barisdinc/ASELSAN_4822/Arduino_Nano_TAMSAT_KIT/Hardware/README.md

Bu dizinde sema, PCB  calismalari vb. yer alacak
