barisdinc/ASELSAN_4822/ESP32_TA1GI/docs/K3 1.resim.pdf

t;

## !ııl

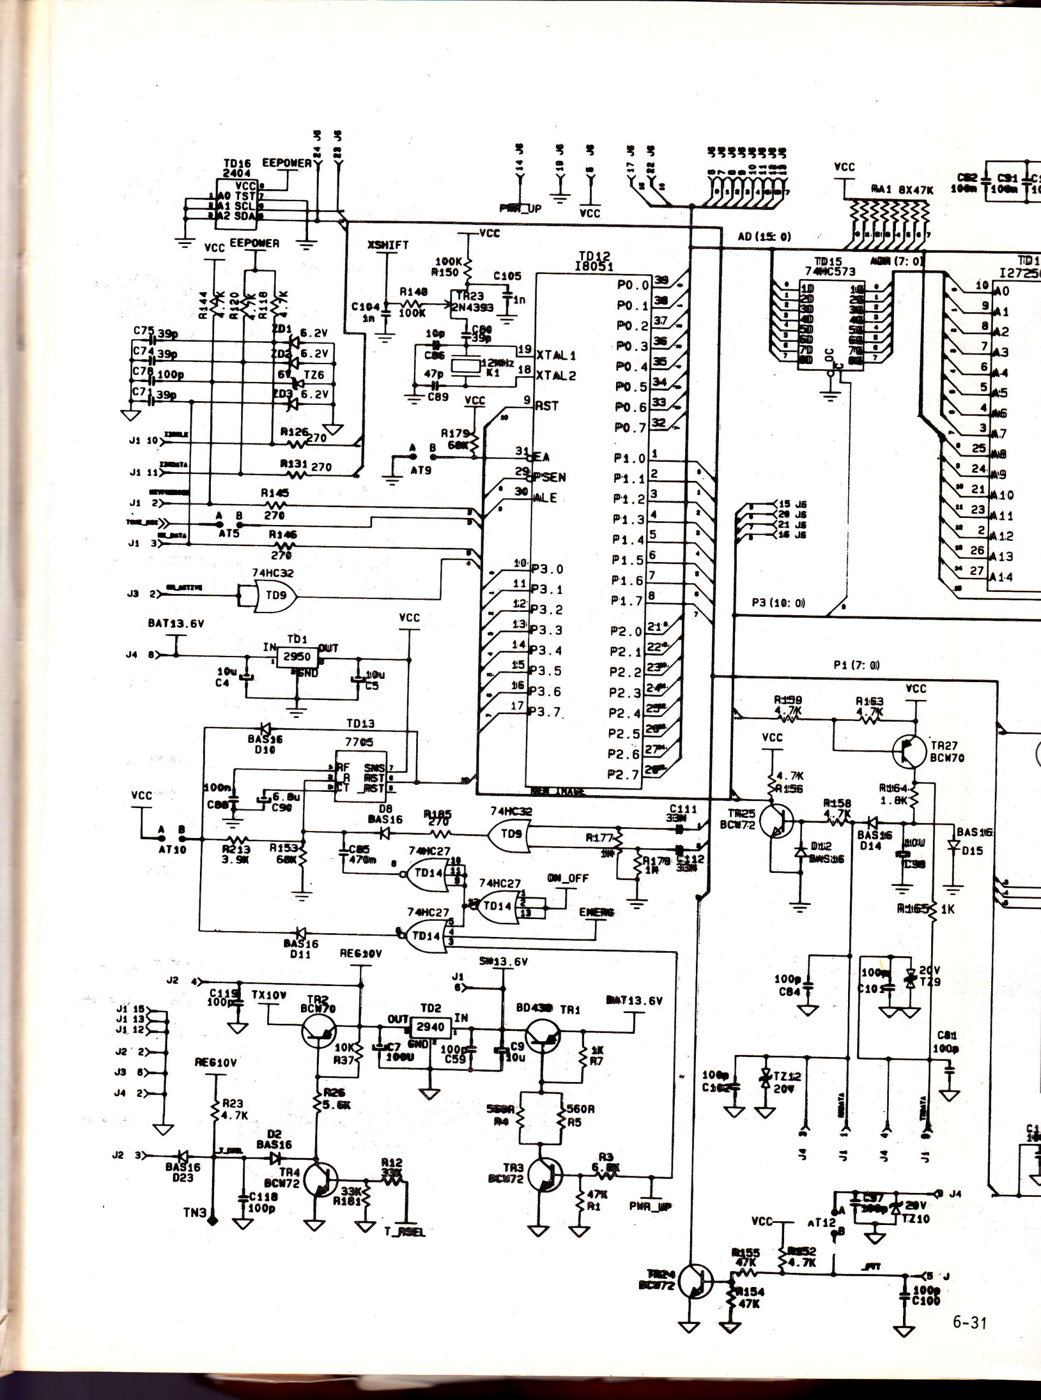
[picture p6: page 1]

EI

ta

# T II *ur:*

ış

la

= YCC

aArı3.6v

## E€l0v

ı(:

## üTı3.6y

^o

(ırİ 0ı

P3 {10: 0'

74HC3?

## ri..l!!

m
BaSr6

### 'n.ı ,,eü? tıı

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
Pı (7: o)
vcc

TR?I
8cİ70

ıK

IE
BCrT?

# vccL

AI

# iıH

t

l0

7 1ılc?7 ü-0FF

3. 6V

### 69çtr Ttt

Tıı:ı
İCE,a

RESNOY

TO?

ırt

ııa

Tı1r|
2G;

Jı
Jt
.rı
J2
.it
J/| | l
*

Ra3
a.7K
: ı

## pİıJ'

D.
3ı172

t
Iı:

## TDıs rn(7: 7ıürc,373

p0.

TAL ı

p0 '
P0.
^t-2 P0.

## ,fs"rs nlff 'ıy

toOD
T-8.

6-3 1
