barisdinc/ASELSAN_4822/Dokumanlar/Arduino-nano_4822-pinout_TA2GY.ods

TA7W TAMSAT ASELSAN 4822 ARDUINO BAĞLANTI DEĞİŞİKLİKLERİ – 03.01.2017
TA7W
 |  |  |  |  |  |  |  | YAPILACAKLAR
 |  | <- | TX1 | ICSP | VIN | -> |  | 1) PTT in ve OUT u birlestir
 |  | <- | RX0 |  | GND | -> | (TD12/P20) (TD11/P21[EKLE]) | 2) GPS portlarini ayarla, mumkunse A1 ve A3 disinda
 |  | <- | RST |  | RST | ->
 | (TD12/P20) | <- | GND |  | 5V | -> | (TD12/P40)
 | SQL (TD12/P14) | <- | D2 |  | A7 | ->
 | TONE OUT (RA2/P10) | <- | D3 | ARDUINO | A6 | ->
 | MUTE_1 (TD11/P22) | <- | D4 | NANO | A5 | -> | I2C_CLK (TD12/P2)
 | TUS INTR (TD12/P12) | <- | D5 | V3 | A4 | -> | I2C_DATA (TD12/P3)
 |  | <- | D6 |  | A3 | ->
 | PLL_SEC (TD12/P8) | <- | D7 |  | A2 | -> | PLL_SEC (TD11/P5) (TD9/P5-P9)
 | SPI_DATA (TD12/P5) | <- | D8 |  | A1 | -> | POWER_CONTROL (TD11/P2)
 | SPI_CLK (TD12/P6) | <- | D9 |  | A0 | -> | POWER_ON-OFF (TD12/P9)
 | PTT_OUT (J2/P3) | <- | D10 |  | REF | ->
 | PTT_IN (TD12/P1) | <- | D11 |  | 3V3 | ->
 | BS0 (TD11/P27) | <- | D12 |  | D13 | -> | BS1 (TD11/P28)
 |  |  |  | USB
TA2GY
 |  | <- | TX1 | ICSP | VIN | ->
 |  | <- | RX0 |  | GND | -> | (TD12/P20) (TD11/P21[EKLE])
 |  | <- | RST |  | RST | ->
 | (TD12/P20) | <- | GND |  | 5V | -> | (TD12/P40)
 | SQL (TD12/P14) | <- | D2 |  | A7 | -> | POWER_CONTROL (TD11/P2)
 | TONE OUT (RA2/P10) | <- | D3 | ARDUINO | A6 | -> | PLL_SEC (TD11/P5) (TD9/P5-P9)
 | TUS INTR (TD12/P12) | <- | D4 | NANO | A5 | -> | I2C_CLK (TD12/P2)
 | PTT_OUT (J2/P3) | <- | D5 | V3 | A4 | -> | I2C_DATA (TD12/P3)
 | MUTE_1 (TD11/P22) | <- | D6 |  | A3 | -> | POWER_ON-OFF (TD12/P9)
 | PLL_SEC (TD12/P8) | <- | D7 |  | A2 | ->
 | BS1 (TD11/P28) | <- | D8 |  | A1 | ->
 | SPI_CLK (TD12/P6) | <- | D9 |  | A0 | ->
 | SPI_DATA (TD12/P5) | <- | D10 |  | REF | ->
 | BS0 (TD11/P27) | <- | D11 |  | 3V3 | ->
 | PTT_IN (TD12/P1) | <- | D12 |  | D13 | ->
 |  |  |  | USB
TA7W -> TA2GY
+ | D2 -> D2 |  |  |  |  | ? | A0 -> A3
+ | D3 -> D3 |  |  |  |  | ? | A1 -> A7
? | D4 -> D6 |  |  |  |  | ? | A2 -> A6
? | D5 -> D4 |  |  |  |  | + | A4 -> A4
+ | D7 -> D7 |  |  |  |  | + | A5 -> A5
? | D8 -> D10
+ | D9 -> D9
? | D10 -> D5
? | D11 -> D12
? | D12 -> D11
? | D13 -> D8
