barisdinc/ASELSAN_4822/ESP32_TA1GI/docs/K3 2.resim.pdf

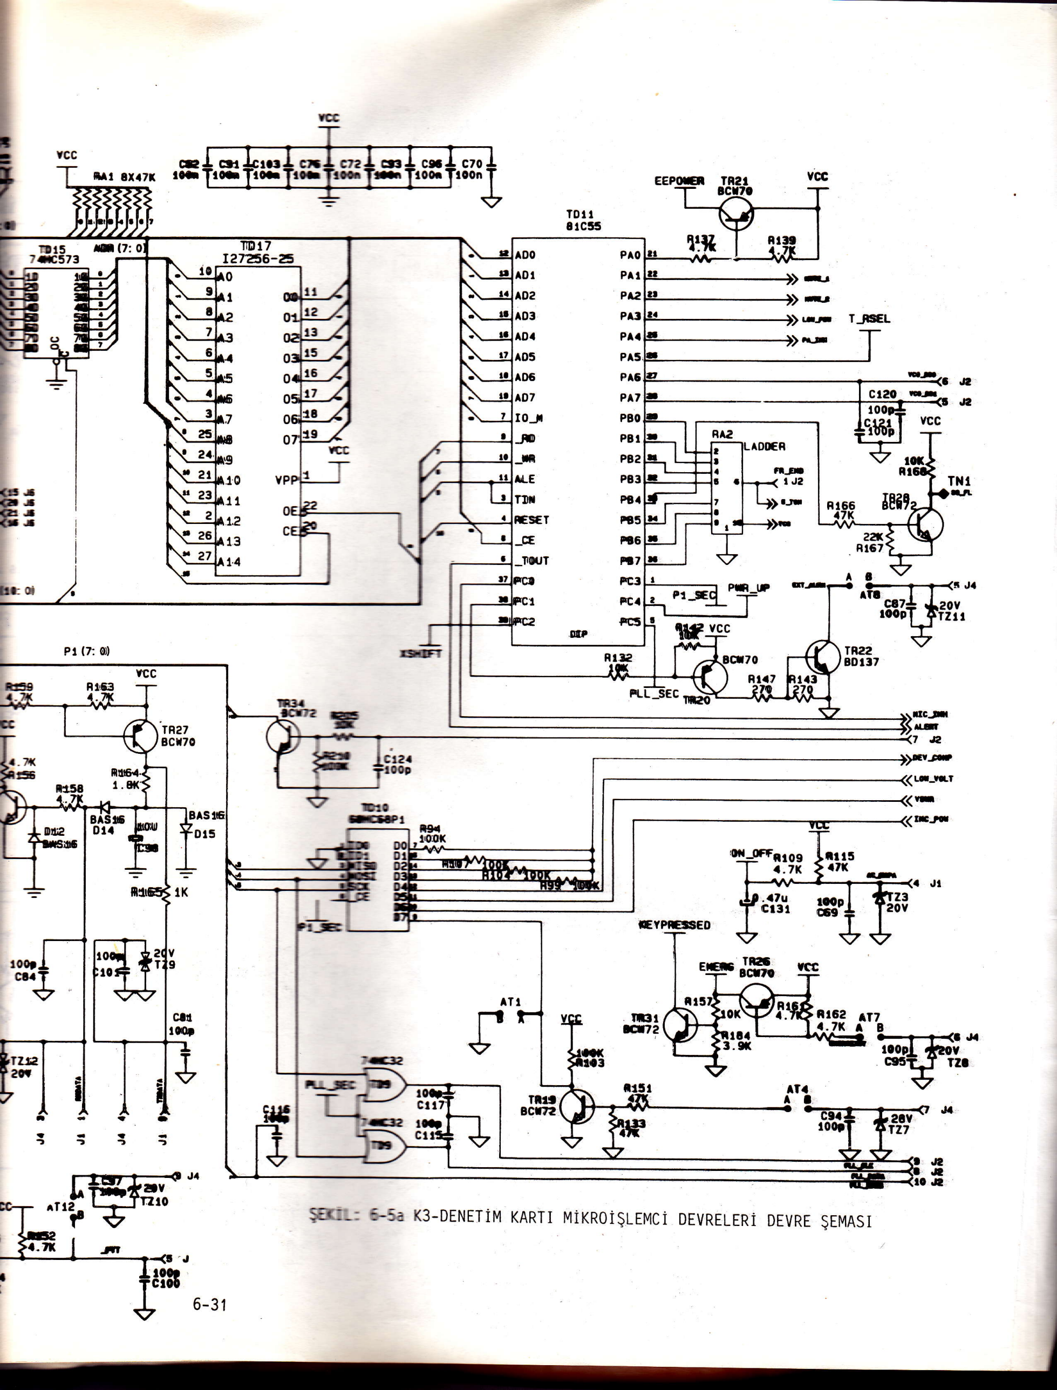
[picture p34: page 1]

CE ıAt eıa7x ıcİ

I
I
J
I

0a

TDı ı
tıc:r!ı

.ı,Jı
aı.Jı
ı.ı-ıf TJı!İEL
ır_ı

ct2o ııJ:

ü,
Rı67
ı

# .ffit"

,88ıf tşrl' ?
TR2? v
80ıı,

.aru cı3ı
GYPEısEo

Tı23 lorıD

ıco0
OB9 r

Rı62
a.7K

6-3 1

Fİ]il- 5.5a K3-DENETİM KARTI MİKRoİŞLEMCi DEVRELERi DEVRE şEMASI
