barisdinc/ASELSAN_4822/Arduino_Nano_TAMSAT_KIT/Hardware/2Layer/Top.jpg

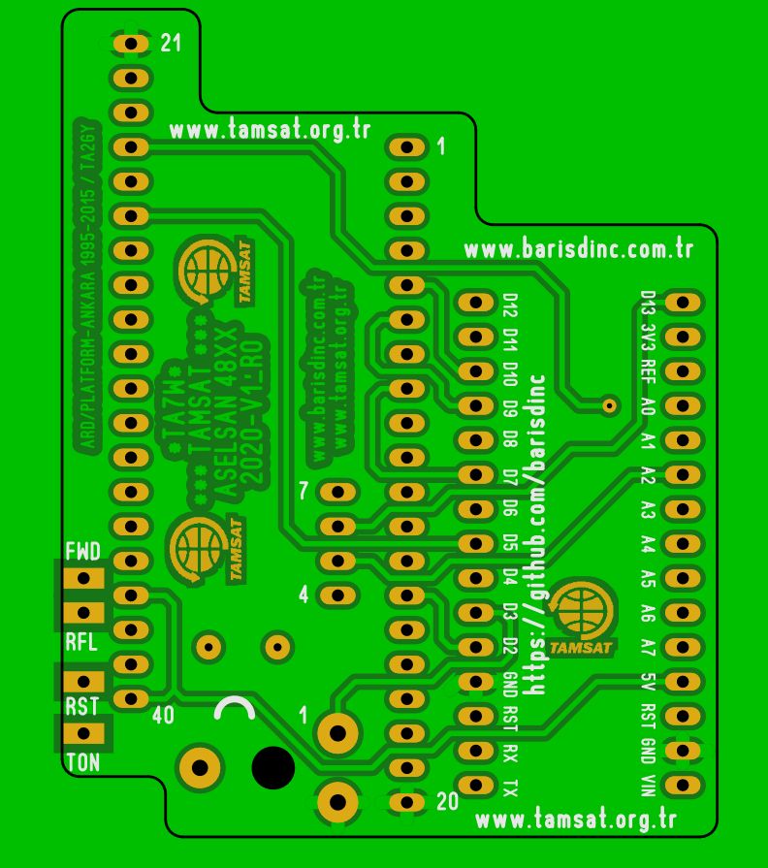
Arduino_Nano_TAMSAT_KIT/Hardware/2Layer/Top.jpg
