barisdinc/ASELSAN_4822/Dokumanlar/Band_Selection_Table_From_Aselsan.png

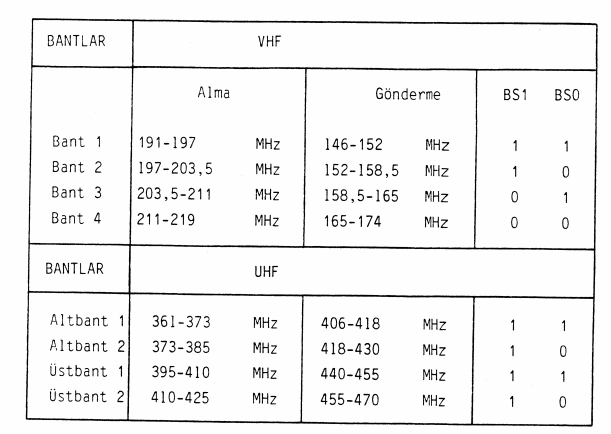
Dokumanlar/Band_Selection_Table_From_Aselsan.png
