barisdinc/ASELSAN_4822/Dokumanlar/PC_Program_PDR.jpeg

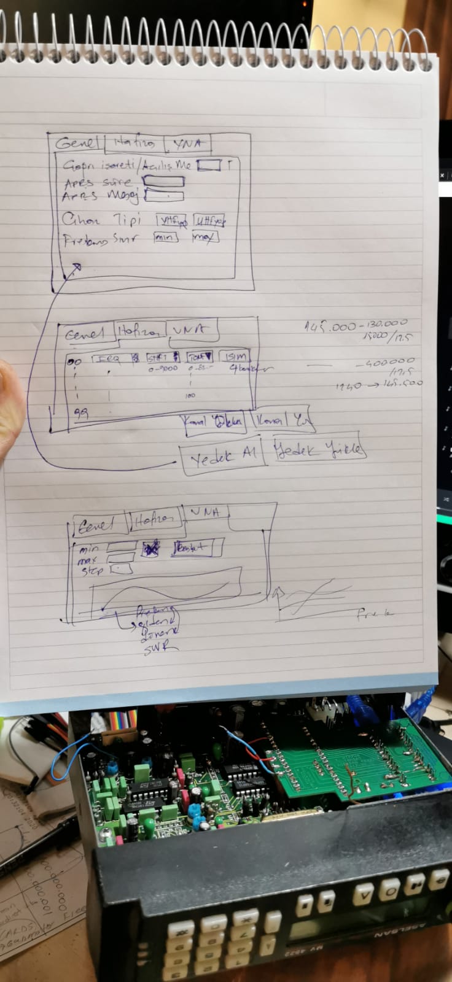
Dokumanlar/PC_Program_PDR.jpeg
