barisdinc/ASELSAN_4822/ESP32_TA1GI/docs/PINOUT Arduino.jpg

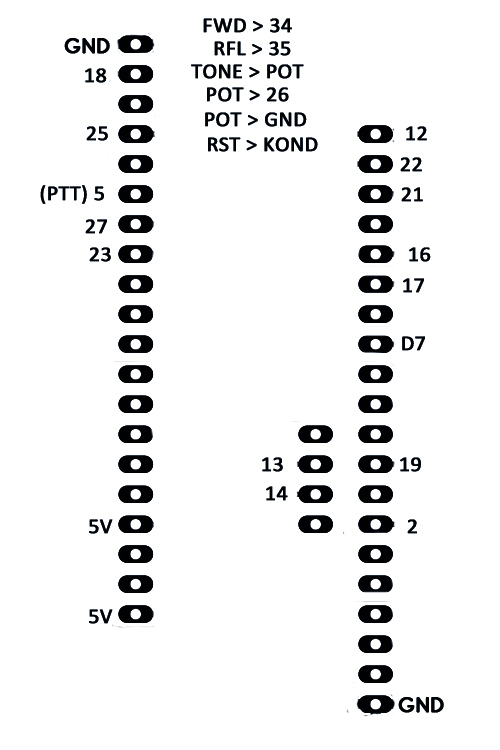
ESP32_TA1GI/docs/PINOUT Arduino.jpg
