barisdinc/ASELSAN_4822/ESP32_TA1GI/docs/PINOUT esp32.jpg

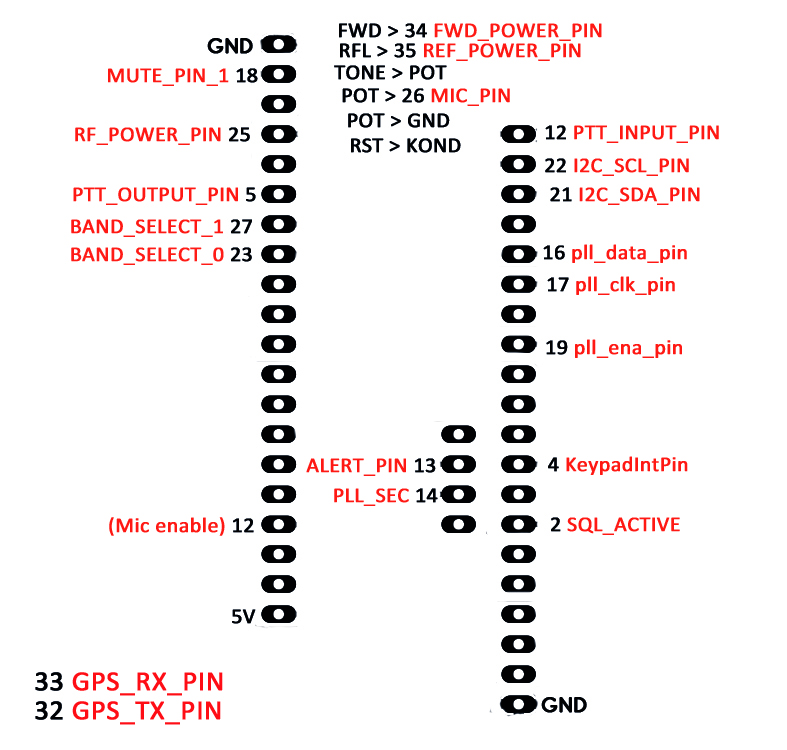
ESP32_TA1GI/docs/PINOUT esp32.jpg
