barisdinc/ASELSAN_4822/RaspiPico_TA2DMX/pcb/BOM_Board1_PCB1_2025-11-10.xlsx

No. | Quantity | Comment | Designator | Footprint | Value | Manufacturer Part | Manufacturer | Supplier Part | Supplier
1 | 4 | 100nF | C1,C2,C3,C4 | C0805 | 100nF
2 | 3 | 2.54-1*4 | GPS1,TNC1,U4 | HDR-TH_4P-P2.54-V-M-1 |  | 2.54-1*4 | ZHOURI(洲日) | C5116483 | LCSC
3 | 2 | NCD0805R1 | LED1,LED2 | LED0805-R-RD |  | NCD0805R1 | 国星光电 | C84256 | LCSC
4 | 1 | 10K | PR1 | RES-ADJ-TH_3P-L9.5-W9.5-P2.54-BR-BS | 10K
5 | 1 | DTC143EKA | Q1 | SOT-23-3_L2.9-W1.3-P1.90-LS2.4-BL-1 |  | DTC143EKA | BLUE ROCKET(蓝箭) | C7429768 | LCSC
6 | 1 | 100R | R1 | R0805 | 100R | MFH05HR010FT | FH(风华) |  | LCSC
7 | 2 | 10K | R2,R4 | R0805 | 10K | MFH05HR010FT | FH(风华) |  | LCSC
8 | 2 | R | R3,R5 | R0805 | R | MFH05HR010FT | FH(风华) |  | LCSC
9 | 2 | 1K | R6,R8 | R0805 | 1K | MFH05HR010FT | FH(风华) |  | LCSC
10 | 1 | 22K | R7 | R0805 | 22K | MFH05HR010FT | FH(风华) |  | LCSC
11 | 1 | 81C55 | TD1 | 81C55
12 | 1 | PH2.54-01-20PZD | TD2 | HDR-TH_20P-P2.54-V-M-4 |  | PH2.54-01-20PZD | XUNPU(讯普) | C7501591 | LCSC
13 | 1 | PICO W | U1 | COMM-SMD_L51.0-W21.0-P2.54_PICOW |  | PICO W | Raspberry Pi(树莓派) | C7203003 | LCSC
14 | 2 | SS14 | U2,U3 | SMA_L4.3-W2.7-LS5.1-RD |  | SS14 | WPMtek(维攀) | C2766061 | LCSC
