barisdinc/ASELSAN_4822/(threads)

Thread 15 (2018-09-12):

SHIFT - isareti cikmiyor

barisdinc, 2018-09-12:
Shift degistirme tusu + - ve bosluk arasinda degisip shiftMODE degiskeninin degeri degismesi lazim.. sanirim bu sequence de bir hatamiz var

barisdinc, 2018-09-12:
duplicate

Closed 2018-09-12.

Thread 18 (2019-08-01):

ekran ledlerinin kapatilmasi

barisdinc, 2019-08-01:
cihaz belli bir sure kullanilmadiginda ekranin karartilmasi guzel olabilir

ToygarVarli, 2019-08-01:
Barış Hocam selamlar ,

Uzun zamandır geliştirme yapmıyorduk cihazla ilgili .

Bu issue'ye assign oldum ben.

SleepTimer yapacağım , tuş takımından gelen interrupt durumuna göre sleeptimer'ı sıfırlayacağım.

Şimdilik 5 saniye olarak sabit yapıyorum. Sonrasında konfigüre edilebilir duruma getiririz.

barisdinc, 2019-08-01:
Eyvallah... Sagilasin

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

Closed 2020-02-22.

Thread 19 (2020-02-21):

APRS icin ISS frekansina da gecmek

barisdinc, 2020-02-21:
144.800 gibi 145.8XX de ISS e de arada APRS gondermek via ISS seklinde

Tesekkur : Suleyman Ozturk

barisdinc, 2020-02-23:
once 144.800 e gecip gonderim yapiyor ardindan 145.825 den ISS e yayin yapiyor...
ayarlar su sekilde
destination : TAMSAT
DIGI/VIA : ARISS

Closed 2020-02-23.

Thread 41 (2020-03-29):

Software device reset function fix

barisdinc, 2020-03-29:
reset device when needed..
function added but not workimng

Thread 42 (2020-03-29):

Watchdog reset issue

barisdinc, 2020-03-29:
There's a bug for watchdog with current bootloader..
shoudl be fixed

https://forum.arduino.cc/index.php?topic=483731.0
