barisdinc/ASELSAN_4822/Dokumanlar/Arduino-nano_4822-pinout_TA2GY.pdf

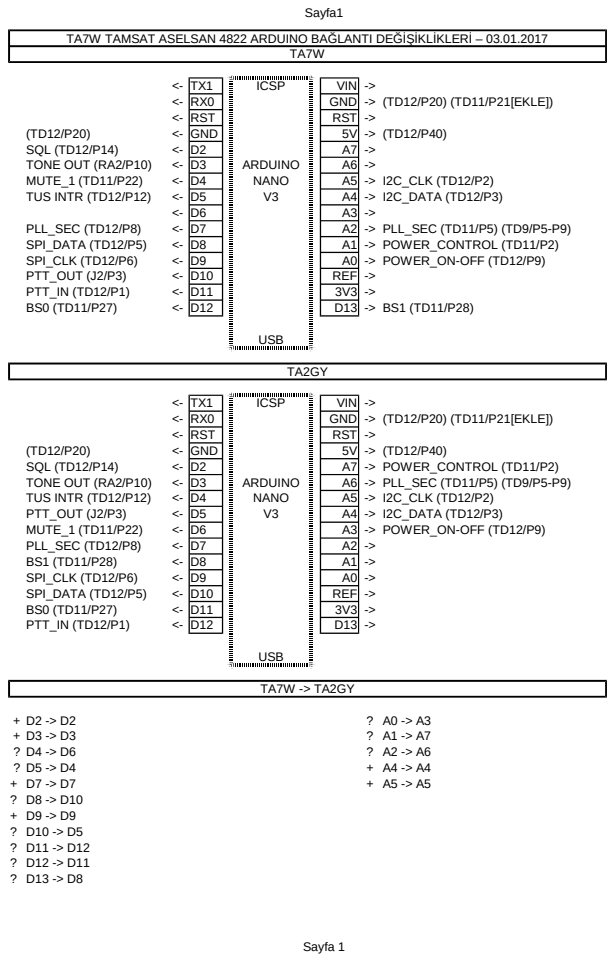
[picture p41: page 1]

TA7W TAMSAT ASELSAN 4822 ARDUINO BAĞLANTI DEĞİŞİKLİKLERİ – 03.01.2017
