barisdinc/ASELSAN_4822/RaspiPico_TA2DMX/schematic/SCH_Schematic.pdf

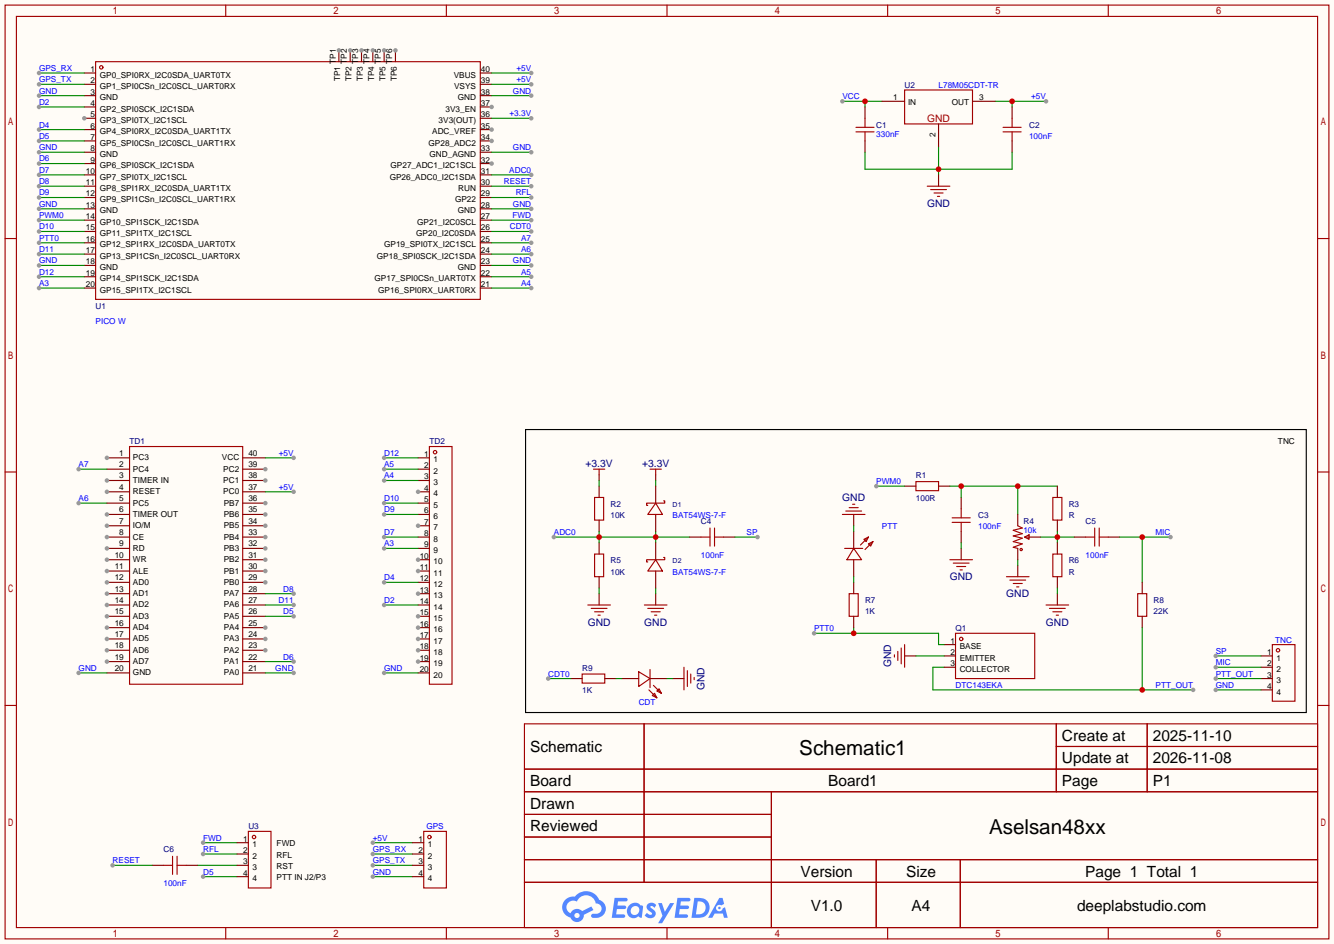
[picture p42: page 1]

Schematic | Schematic1 | Create at | 2025-11-10

Update at | 2026-11-08

Board | Board1 | Page | P1
Drawn | | Aselsan48xx
Reviewed

Version | Size | Page 1 Total 1
V1.0 | A4 | deeplabstudio.com
