barisdinc/ASELSAN_4822/Arduino_Nano_TAMSAT_KIT/Hardware/GEN-TA7W_TAMSAT-Aselsan_4822-TA2GY_05042019.pdf

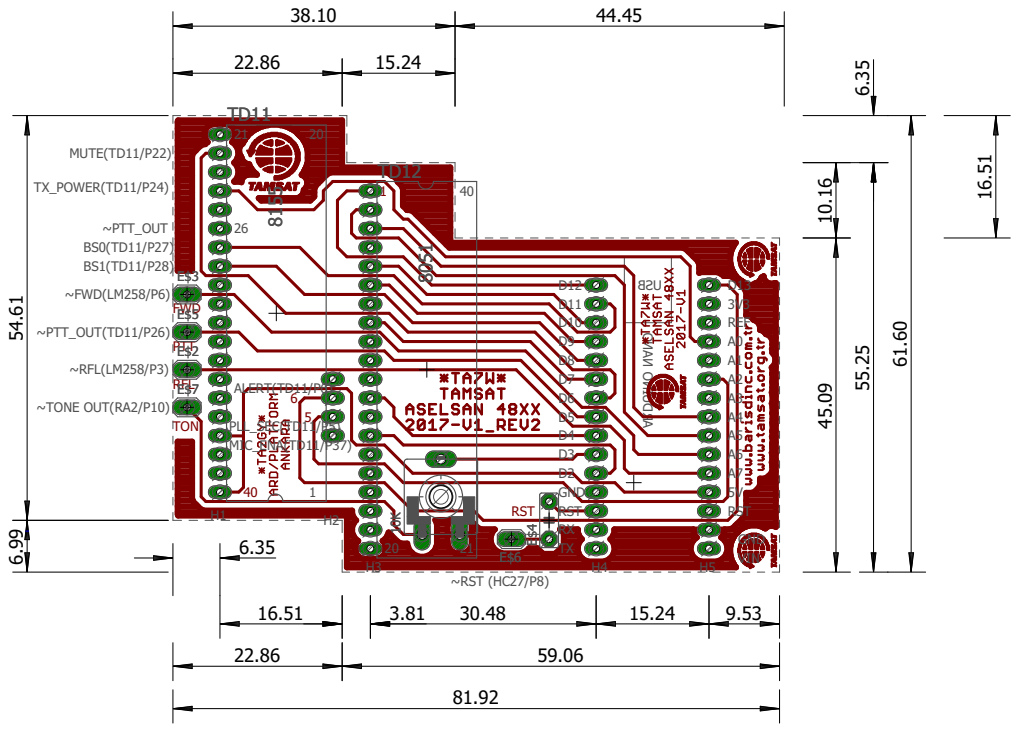
[picture p43: page 1]

BSU ARDUINO NANO 1 40 5 6 FWD PTT RFL TON RST TXD11 D10 D2D4D5D7D8D9D12 D13 A03V3 A1A4A55VRST 40 20 21 GND A2 BS0(TD11/P27) BS1(TD11/P28) A3A6A7 D6D3RST GND REF ~PTT_OUT(TD11/P26) ~TONE OUT(RA2/P10) MUTE(TD11/P22) H3 H4 H5 RX ~FWD(LM258/P6) ~RFL(LM258/P3) TX_POWER(TD11/P24) ALERT(TD11/P6) H1 H2 21 120 ~RST (HC27/P8) VIN MIC_ENA(TD11/P37) PLL_SEC(TD11/P5) ~PTT_OUT 26 TD12 E$3 E$2 E$5 E$7 TD11 10K E$4 E$6 8051 8155 45.09 10.16 6.35 61.60 22.86 59.06 81.92 55.25 44.45 22.86 15.24 54.61 6.99 16.51 3.81 30.48 15.24 38.10 6.35 16.51 9.53
