barisdinc/ASELSAN_4822/Arduino_Nano_TAMSAT_KIT/Hardware/PCB-TA7W_TAMSAT-Aselsan_4822-TA2GY_05042019.pdf

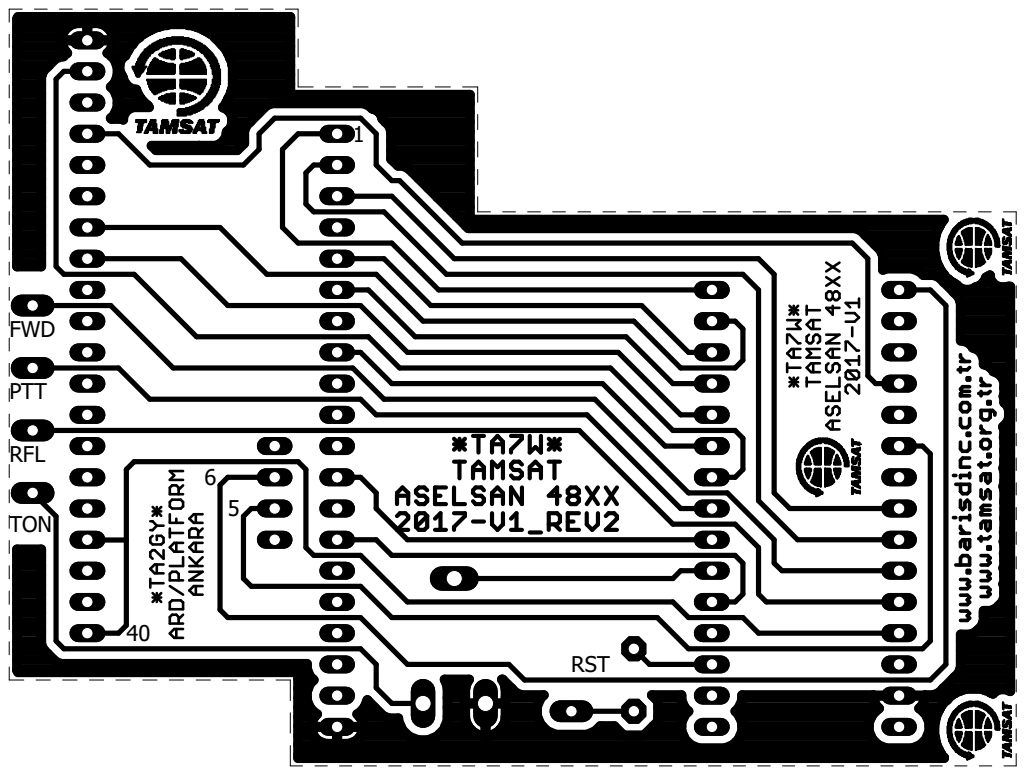
[picture p44: page 1]
