barisdinc/ASELSAN_4822/Arduino_Nano_TAMSAT_KIT/Software/src/ASELSAN_4822.cpp

#include "ASELSAN_4822.h"
#include <Arduino.h> //For platformio compability
#include <avr/wdt.h>
#include <Wire.h>
#include <EEPROM.h>
#include <avr/pgmspace.h>
#include <avr/interrupt.h>
#include <avr/io.h>
#include <math.h>
#include <stdio.h>
#include <SoftwareSerial.h>
#include <TinyGPS.h>
//#include "ASELSAN_lcd.h"
//#include "../lib/fontsandicons.h"
//#include "./libraries/PinChangeInt.h"
#define Serialprint(format, ...) StreamPrint_progmem(Serial,PSTR(format),##__VA_ARGS__)
#define Streamprint(stream,format, ...) StreamPrint_progmem(stream,PSTR(format),##__VA_ARGS__)

//Function definitions
//TODO: move these to a header file
void StreamPrint_progmem(Print &out,PGM_P format,...);






//Interrupts      
// PCINT20 is in PCINT2 vector 
//ISR(PCINT20_vect) 
//{
// KeyVal = digitalRead(KeypadIntPin);
// //digitalWrite(PTT_OUTPUT_PIN, KeyVal); //for testing
//}


void Alert_Tone(int ToneType)
{
  if (TRX_MODE == TX)  return; //If we are transmitting, do not play tones, because tone pin might be busy with CTCSS generation
  noTone(MIC_PIN); //First silence the TONE output first
  if (ToneType == OK_tone)  { tone(ALERT_PIN,1000,ALERT_MODE); Serialprint(" OK\r\n");}   //short 1Khz is OK  tone
  if (ToneType == ERR_tone)  tone(ALERT_PIN,400 ,ALERT_MODE*2); //long 440hz is ERR tone
  if (ToneType == SUCC_tone) {tone(ALERT_PIN,600 ,ALERT_MODE);delay(200);tone(ALERT_PIN,1000 ,ALERT_MODE);} //2 500msec success tones
  delay(ALERT_MODE); //TODO: find a better way to play two tones simultaneously
  SetTone(current_ch.tone_enabled); //resume Tone Generation 
}


/*
char numberToArray (int Number) //max 4 digits
{
//TODO: 
//  char result = "         ";
//  result[0] = String(Number / 1000);
//  result[1] = String(Number / 100);
//  result[2] = String(Number / 10);
//  result[3] = String(Number / 1);
  
  
}
*/
boolean Calculate_Frequency (char mFRQ[9]) {

  current_ch.frequency = ((mFRQ[0]-48) * 100000L) + ((mFRQ[1]-48) * 10000L)  + ((mFRQ[2]-48) * 1000) + ((mFRQ[4]-48) * 100) + ((mFRQ[5]-48) * 10) + (mFRQ[6]-48);
  if (radio_type==0 && (current_ch.frequency >= (freqLimits.trx_min_125*12.5)) & (current_ch.frequency <= (freqLimits.trx_max_125*12.5))) return true; //valid frequency for VHF
//  if (radio_type==0 && (current_ch.frequency >= 134000) & (current_ch.frequency <= 174000)) return true; //valid frequency for VHF
  else if (radio_type==1 && (current_ch.frequency >= 400000L) & (current_ch.frequency < 468400L)) return true; //valid frequency for UHF
  else 
    {
      Alert_Tone(ERR_tone);
      return false; //invalid frequency
    }
}


void SetPLLLock(uint32_t Frequency)
{
  int R_Counter =0;
  int N_Counter = 0;
  int A_Counter = 0;
  if(radio_type==0) //TODO: else portion seems exactly the same ????
  {
    if (TRX_MODE == RX) Frequency = Frequency + 45000L;
    if (TRX_MODE == TX) Frequency = Frequency + (current_ch.shift_dir * current_ch.shift) ; // Add/remove transmission shift
  
     R_Counter = 12800 / 12.5;  //12.8Mhz reference clock, 25Khz step
     N_Counter = Frequency / 12.5 / 80 ; //prescaler = 80, channel steps 25Khz
     A_Counter = (Frequency / 12.5) - (80 * N_Counter);


    digitalWrite(PLL_SEC, LOW); //SELECT PLL for SPI BUS  
    send_SPIBit(R_Counter,14);
    send_SPIBit(1,1); // Tell PLL that it was the R Counter
    send_SPIEnable();
    send_SPIBit(N_Counter,10);
    send_SPIBit(A_Counter,7);
    send_SPIBit(0,1); // Tell PLL that it was the A and N Counters  
    send_SPIEnable();  
    digitalWrite(PLL_SEC, HIGH); //DE-SELECT PLL for SPI BUS
  }
  else
  {
    if (TRX_MODE == RX) Frequency = Frequency - 45000L;
    if (TRX_MODE == TX) Frequency = Frequency + (current_ch.shift_dir * current_ch.shift) ; // Add/remove transmission shift
  
     R_Counter = 12800 / 12.5;  //12.8Mhz reference clock, 25Khz step
     N_Counter = Frequency / 12.5 / 80 ; //prescaler = 80, channel steps 25Khz
     A_Counter =(Frequency / 12.5) - (80 * N_Counter);

  
    digitalWrite(PLL_SEC, LOW);
    send_SPIBit(R_Counter,14);
    send_SPIBit(1,1); 
    send_SPIEnable();
    send_SPIBit(N_Counter,10);
    send_SPIBit(A_Counter,7);
    send_SPIBit(0,1); 
    send_SPIEnable();  
    digitalWrite(PLL_SEC, HIGH); 
  }
}


void write_FRQ(uint32_t Frequency) {
//VHF BAND SELECTION  
//BS0 BS1
// 0  0     152.2   172.6
// 0  1     147.9   165.5
// 1  0     141.6   157.1
// 1  1     137.2   151.4
//+------------+---------------+-----+-----+
//| Radio Type |  Frequency    | BS0 | BS1 |
//+------------+---------------+-----+-----+
//| VHF        | 152.2   172.6 |   0 |   0 |
//|            | 147.9   165.5 |   0 |   1 |
//|            | 141.6   157.1 |   1 |   0 |
//|            | 137.2   151.4 |   1 |   1 |
//+------------+---------------+-----+-----+

//+------------+---------------+-----+-----+
//| Radio Type |  Frequency    | BS0 | BS1 |
//+------------+---------------+-----+-----+
//| UHF        | 406.0   418.0 |   1 |   1 |
//|            | 418.0   430.0 |   0 |   1 |
//|            | 440.0   455.0 |   1 |   0 |
//|            | 455.0   470.0 |   0 |   0 |
//+------------+---------------+-----+-----+

//uint32_t UpdatedFrq = 0;
//float divider = 0;
  if (validFRQ) {
    if(radio_type==0)
    {
      if ((Frequency < 174000L) & (Frequency >= (164000L)))  { digitalWrite(BAND_SELECT_0, LOW);  digitalWrite(BAND_SELECT_1, LOW);  }
      if ((Frequency < 164000L) & (Frequency >= (154000L)))  { digitalWrite(BAND_SELECT_0, LOW);  digitalWrite(BAND_SELECT_1, HIGH); } 
      if ((Frequency < 154000L) & (Frequency >= (144000L)))  { digitalWrite(BAND_SELECT_0, HIGH); digitalWrite(BAND_SELECT_1, LOW);  } 
      if ((Frequency < 144000L) & (Frequency >= (134000L)))  { digitalWrite(BAND_SELECT_0, HIGH); digitalWrite(BAND_SELECT_1, HIGH); } 
    }
    else if(radio_type==1)
    {
       if ((Frequency < 470000L) & (Frequency >= (452000L))) {digitalWrite(BAND_SELECT_0, LOW); digitalWrite(BAND_SELECT_1, LOW); }
       if ((Frequency < 452000L) & (Frequency >= (430000L))) {digitalWrite(BAND_SELECT_0, HIGH);digitalWrite(BAND_SELECT_1, HIGH);}
    // Update EEPROM for last used Frequncy
    }
//BD1    current_ch.frequency = Frequency; //UpdatedFrq;
//BD1    EEPROM.put(EEPROM_CURRCHNL_BLCKSTART,current_ch); 
    SetPLLLock(Frequency);
  } //validFRQ 
}



void write_SHIFTtoLCD(uint16_t FRQshift) {
 if (FRQshift>=9975) FRQshift=9975; //upper limit check
 if (FRQshift<=0)    FRQshift=0;    //lower limit check
 
 char MSG[8];
 dtostrf(FRQshift, 7, 0, MSG);
 MSG[8] = 0;
 writeToLcd(MSG);
    
}


void write_TONEtoLCD(unsigned long tone_pos) {
 char MSG[8];
 dtostrf(ctcss_tone_list[tone_pos], 7, 1, MSG);
 MSG[8] = 0;
 writeToLcd(MSG);
}


//void SetRFPower(int rfpowerSTATE) {
void SetRFPower() {
    digitalWrite(RF_POWER_PIN, RF_POWER_STATE);
}

void setRadioPower() {
  //Is the radio turned on ?
  //SYS_MODE = digitalRead(POWER_ON_OFF);
  //if ( SYS_MODE == SYS_ON)  digitalWrite(POWER_ON_PIN, HIGH) ;
  //if ( SYS_MODE == SYS_OFF) digitalWrite(POWER_ON_PIN, LOW) ; 

  //if ( SYS_MODE == SYS_ON)  Serial.println("POWER ON")  ; 
  //if ( SYS_MODE == SYS_OFF) Serial.println("POWER OFF") ; 
}


void readRfPower()
{
   int refPower = 0;
   int fwdPower = 0;
   
   fwdPower = analogRead(FWD_POWER_PIN);
   refPower = analogRead(REF_POWER_PIN);
   //refPower = refPower * 2;
   //int Ptoplam = fwdPower + refPower;
   int Pfark   = fwdPower - refPower;
   float swr = Pfark; //gecici (float)Ptoplam / (float)Pfark;
   Serial.print("\t");
   Serial.print(fwdPower);
   Serial.print("\t");
   Serial.print(refPower);
   Serial.print("\t");
   Serial.print(swr);
   Serial.println("");
   if (swr < minSWR)
   {
      minSWR=swr;
      lowestFRQ=current_ch.frequency;
      highestFRQ=current_ch.frequency;
   } else if (swr == minSWR)
   {
      highestFRQ=current_ch.frequency;
   }

}


void numberToFrequency(uint32_t Freq, char *rFRQ) {
  
  word f1,f2,f3,f4,f5,f6; //sgould be byte, but arduino math fails here.. so changed to double

  f1   = Freq / 100000;
  Freq = Freq - ( f1 * 100000);
  f2   = Freq / 10000;
  Freq = Freq - ( f2 * 10000);
  f3   = Freq / 1000;
  Freq = Freq - ( f3 * 1000);
  f4   = Freq / 100;
  Freq = Freq - ( f4 * 100);
  f5   = Freq / 10;
  Freq = Freq - ( f5 * 10);
  f6   = Freq;

  rFRQ[0] = numbers[f1];
  rFRQ[1] = numbers[f2];
  rFRQ[2] = numbers[f3];
  rFRQ[3] = '.';
  rFRQ[4] = numbers[f4];
  rFRQ[5] = numbers[f5];
  rFRQ[6] = numbers[f6];
  rFRQ[7] = ' ';
  rFRQ[8] = 0;
  //Serialprint("%c %c %c %c %c %c \r\n",rFRQ[0],rFRQ[1],rFRQ[2],rFRQ[3],rFRQ[4],rFRQ[5],rFRQ[6]);
  //strcpy(rFRQ,"145.775 ");
}

void eeread_nbytes(String *dst, uint8_t sz, uint16_t addr)
{
  String edata = "";  
  for (uint8_t cn=0;cn<sz;cn++) edata.concat((char)EEPROM.read(addr+cn));
  *dst = edata;
}

void eeprom_readAPRS()
{
  //APRS Settings
  eeread_nbytes(&APRS_Message,28,20);
  eeread_nbytes(&mycall,6,60);
  APRS_Timeout = EEPROM.read(66);
  eeread_nbytes(&lat,8,67);
  eeread_nbytes(&lon,8,75);
}

void eewrite_nbytes(String dst, uint8_t sz, uint16_t addr)
{
  while (sz--) EEPROM.write(addr+sz,dst[sz]);  //Serialprint("%d %d %d\r\n",sz,addr+sz,dst[sz]);
}

void eeprom_writeAPRS()
{
    //APRS Settings
    eewrite_nbytes(APRS_Message,28,20);
    eewrite_nbytes(mycall,6,60);
    EEPROM.write(66,APRS_Timeout); //Aprs timeout in minutes
    eewrite_nbytes(lat,8,67);
    eewrite_nbytes(lon,8,75);
    Alert_Tone(OK_tone);
}




/*
  TOT Function

  BAKIM ONARIM KITABI - SF. 205 - 6/25
  
  Göndermede kalma süresi isteğe göre 0-225 saniye aralığında 15 saniyelik adımlarla seçilebilir;
  standart programda 1 dakikadır. Zaman sınırlama süresi bitiminde tekrar bas/konuş mandalina basıldığında
  telsizin göndermeye geçmesi için gereken süre de isteğe göre 0 ile 75 saniye aralığında 5 saniyelik
  adımlarla programlanabilir; standart alarak 0 saniyedir.
*/

unsigned long prevTotMillis = 0;
uint8_t TOT_TX_TIME[16] = {0, 15, 30, 45, 60, 75, 90, 105, 120, 135, 150, 165, 180, 195, 210, 225};
uint8_t TOT_TX_LOCK_TIME[16] = {0, 5, 10, 15, 20, 25, 30, 35, 40, 45, 50, 60, 65, 70, 75};

struct tot_t {
  uint8_t  time_out_time = TOT_TX_TIME[4]; 
  uint8_t  lock_time = TOT_TX_LOCK_TIME[1];
};
tot_t tot_values;

int TOT_FLAG = 0;
int TOT_WARN_STATE = 1;

void changeTotSettings(uint8_t timeout, uint8_t lock){
  tot_t  tot_values_new;
  tot_values_new.time_out_time = timeout;
  tot_values_new.lock_time = lock;
  EEPROM.put(EEPROM_TOT, tot_values_new);
  tot_values = tot_values_new;
}

uint8_t TXTimeOutTimer(uint8_t PTT_PIN_STATE) {
  unsigned long currentMillis = millis();
  if (PTT_PIN_STATE == HIGH) {
    if (currentMillis - prevTotMillis >= tot_values.time_out_time* 1000) {
      if (currentMillis - prevTotMillis >= tot_values.time_out_time* 1000 + tot_values.lock_time* 1000) {
        prevTotMillis = currentMillis;
      }
      //digitalWrite(POW_INH, HIGH);
      //Serial.println("transmit interrupted by tot...");
      TOT_FLAG = 1;
      return LOW;
    }
    TOT_FLAG = 0;
    TOT_WARN_STATE = 1;
    return HIGH;
  } else {
    TOT_FLAG = 0;
    TOT_WARN_STATE = 1;
    return LOW;
  }
}



void initialize_eeprom() {  
    EEPROM.write(0, 127); // make eeprom initialized
    EEPROM.write(1, SW_MAJOR);   //SW Version
    EEPROM.write(2, SW_MINOR);   //
    eewrite_nbytes(APRS_DEFAULT_MYCALL,6,3);
    eewrite_nbytes(APRS_DEFAULT_MYCALL,8,9);//TODO: length is 6 but asking for 8
    EEPROM.write(17,radio_type); // Program device as VHF=0 or UHF=1
    APRS_Message = APRS_DEFAULT_MESSAGE;
    mycall = APRS_DEFAULT_MYCALL;  
    APRS_Timeout = 0;
    lat = APRS_DEFAULT_LAT;
    lon = APRS_DEFAULT_LON;
    eeprom_writeAPRS();
    //for (int location=18;location < 300;location++) EEPROM.write(location,0); // Zeroise the rest of the memory
    channel_t default_channel;
    if (radio_type == 0)
    { 
      default_channel.frequency = 145600; //1248;
      default_channel.shift = 600;
    }
    else
    {
      default_channel.shift = 7600;
      default_channel.frequency = 433500; //2784;
    }
    //current_ch.shift_dir = -1; //Default Shift -
    //current_ch.tone_pos = 0x08;//Default tone 88.5
    //current_ch.tone_enabled = CTCSS_OFF; //Tone is disabled by default
    EEPROM.put(EEPROM_CURRCHNL_BLCKSTART, default_channel);// current_ch);
    freqLimits_t default_limits;
    if (radio_type == 1) {
      default_limits.trx_min_125 = DEFAULT_UHF_MINIMUM_FREQ;
      default_limits.trx_max_125 = DEFAULT_UHF_MAXIMUM_FREQ;
      default_limits.scn_min_125 = DEFAULT_UHF_SCAN_LOWER;
      default_limits.scn_max_125 = DEFAULT_UHF_SCAN_UPPER;
      default_limits.aprs_125    = 34718; // 433.975 MHz
      default_limits.vna_min_125 = 34400; // 430.000 MHz
      default_limits.vna_max_125 = 35200; // 440.000 MHz
    }
    EEPROM.put(EEPROM_SPECIALFRQ_BLCKSTART,default_limits);
    freqLimits = default_limits;


    // TOT EEPROM INIT
     EEPROM.put(EEPROM_TOT, tot_values);


    memorych_t memch;
    memch.frequency125 = 11640; //145500 / 12.5
    memch.shift25      = 24;    //600 / 25
    memch.tone_position= 8;     //88.5
    memch.SSTP         = 1;     // No shift, tone off. power low
    memch.ChannelName[0]  = 'K';
    memch.ChannelName[1]  = 'N';
    memch.ChannelName[2]  = 'L';
    memch.ChannelName[3]  = ' ';


    //TODO: Move to a common function for PC program integration
    // initialize the whole memory channels
    for (int ch=0;ch<50;ch++)
        EEPROM.put(EEPROM_MEMDATA_BLCKSTART+ch*10, memch);
    
}

// Stores frequency data to the desired EEPROM location
void StoreFrequency(char mCHNL[9], char mFRQ[9]) {
    uint8_t ChannelNumber = ((mCHNL[0] - 48) * 10) + (mCHNL[1] - 48);
    uint8_t ChannelLocation = EEPROM_MEMDATA_BLCKSTART + ChannelNumber * 10;
    Calculate_Frequency(mFRQ); 
    if (ChannelNumber < 1 || ChannelNumber > 50) { Alert_Tone(ERR_tone); return; }
    
    memorych_t memch;
    memch.frequency125 = (uint16_t)(current_ch.frequency / 12.5);
    memch.shift25 = (uint8_t)(current_ch.shift/25);
    memch.tone_position= current_ch.tone_pos; 
    memch.SSTP =  (current_ch.shift_dir + 1)  + (current_ch.tone_enabled * 4);//TODO: Power is missing + ( power * 8);
    EEPROM.put(ChannelLocation, memch); 
}


/*
 * Retrieves the requested Memory Channel Information from EEPROM and returns a memorych_t tyep object
 */
//memorych_t GetPrintMemoryChannelInfo(int8_t channel_number, boolean dbg) {
void GetPrintMemoryChannelInfo(int8_t channel_number, boolean dbg) {
      memorych_t l_memorych;
      uint8_t ChannelLocation = EEPROM_MEMDATA_BLCKSTART + channel_number * 10;
      EEPROM.get(ChannelLocation, l_memorych);
      //numberToFrequency(freq, FRQ);
      if (dbg) 
      {
        Serialprint("{c:%d,f:%d,s:%d,t:%d}",channel_number,l_memorych.frequency125,l_memorych.shift25,l_memorych.tone_position); //TODO: add name
      }

}

/*
 * Retrieves the requested Memory Channel Information from EEPROM
 * TODO: combine this with the previuous function
 */
void GetMemoryChannel(char mFRQ[9]) {
    uint8_t ChannelNumber = ((mFRQ[0] - 48) * 10) + (mFRQ[1] - 48);
    uint8_t ChannelLocation = EEPROM_MEMDATA_BLCKSTART + ChannelNumber * 10;
    if (ChannelNumber < 1 || ChannelNumber > 50) { Alert_Tone(ERR_tone); return; }
    memorych_t l_memorych;
    EEPROM.get(ChannelLocation, l_memorych);
    current_ch.frequency = l_memorych.frequency125 * 12.5;
    current_ch.shift     = l_memorych.shift25 * 25;
    current_ch.tone_pos  = l_memorych.tone_position;
    current_ch.shift_dir = ((l_memorych.SSTP) & 0x03) - 1; //First 2 bits -1
    current_ch.tone_enabled= ((l_memorych.SSTP) & 0x04) >> 2;  //3rd bit is tone_enabled
                                                          //TODO read power as well
    numberToFrequency(current_ch.frequency, FRQ);
 }

void PrintMenu()
{  
//  print_version();
  Serialprint("ASELSAN 48xx - TAMSAT Kit (v%d.%d-%s) \n\r",SW_MAJOR,SW_MINOR, __DATE__);
  Serialprint("-------------------------\n\r");
  //Serialprint("Y-Yardim\n\r");
  Serialprint("C-VHF/UHF Cevrimi Yap\n\r");
  Serialprint("A-Acilis Mesaji Degistir\n\r");
  Serialprint("F-Frekans Sinirlari\n\r");
  Serialprint("V-Analizor Sinirlari\n\r");
  Serialprint("H-Hafiza Islemleri\n\r");
  Serialprint("K-Konfigurasyon Yaz\n\r");
  Serialprint("S-APRS cagri isareti\n\r");
  Serialprint("T-APRS sessizlik suresi\n\r");
  Serialprint("M-APRS Mesaji\n\r");  
  Serialprint("G-GPS Oku\n\r");  
  Serialprint("Seciminiz >\n\r");
}

void commandYardim(char komut)
{
  /*
  Serialprint("Yardim Menusu\r\n=====================\r\n");
  if (komut=='\n')
  {
    Serialprint("Yardim almak istediginiz komutu belirtiniz...\r\n");
    Serialprint("Ornek : Y C  veya Y F  veya Y A \r\n");
  } else if (komut == 'C')
  {
    Serialprint("Bu komut cihazinizi UHF ya da VHF olarak programlamanizi saglar. (sadece TAMSAT Kartini)\r\n");
    Serialprint("Kullanimi : \r\n      C V : VHF yap\r\n      C U : UHF yap");  
  } 
  else if (komut == 'A')
  {
    Serialprint("Kullanimi : \r\n      A [MESAJ]   Ornek:  A TA7W  (maksimum 6 karakter)\r\n"); 
  } else if (komut == 'H')
  {
    Serialprint("Kullanimi:   H [Kanal_No #2] [isim #6] [Frekans #6] [Shift #5] [Ton #4] \r\n"); // !!!CHANGED!!!!!
    Serialprint("Ornek:       H 01 ROLE-0 145600 +0600 0885 \r\n");
  } else if (komut == 'T')
  {
    Serialprint("Kullanimi:   T [2 basamakli olarak Sure (dakika) (00-99)] (00 iptal demektir) \r\n");
    Serialprint("Ornek:       T 300\r\n");
  } else if (komut == 'M')
  {
    Serialprint("Kullanimi:   M [MESAJ (maksimum 30 karakter) \r\n");
    Serialprint("Ornek:       M Merhaba, Ben BARIS DINC - OH2UDS  \r\n");
  }
  F [Alt-frekans] [ust-frekans]        Frekans araligi 
  V [Alt-frekans] [ust-frekans]        VNA Frekans araligi
  S [0125-5000]                        VNA Step
  H                                    Memory Dump as Json

*/  
}

/*
 * Change device type between VHF/UHF
 */

void commandRadioType(char komut)
{
  komut == 'V' ? radio_type = 0 : radio_type = 1;
  initialize_eeprom();
  //Serialprint("OK\r\n");
  Alert_Tone(OK_tone);
}
/*
 * Change startup screen msg
 */
void commandStartupMSG()
{
  String StartupMSG = "      ";
  for (uint8_t cn=0;cn<6;cn++) StartupMSG[cn] = ((commandString[cn+2] >= 32) and (commandString[cn+2] <= 126)) ?  commandString[cn+2] : ' ';
  eewrite_nbytes(StartupMSG,6,9);
  Alert_Tone(OK_tone);
}

/*
 * Print the configurations in form of JSON array to Serial Port
 */
void commandDumpConfig()
{
  uint8_t Check = EEPROM.read(0);
  uint8_t SW_major = EEPROM.read(1);
  uint8_t SW_minor = EEPROM.read(2);
  char CallSign[7];
  CallSign[0] = EEPROM.read(3);
  CallSign[1] = EEPROM.read(4);
  CallSign[2] = EEPROM.read(5);
  CallSign[3] = EEPROM.read(6);
  CallSign[4] = EEPROM.read(7);
  CallSign[5] = EEPROM.read(8);
  CallSign[6] = 0;
  char Message[9];
  Message[0] = EEPROM.read(9);
  Message[1] = EEPROM.read(10);
  Message[2] = EEPROM.read(11);
  Message[3] = EEPROM.read(12);
  Message[4] = EEPROM.read(13);
  Message[5] = EEPROM.read(14);
  Message[6] = EEPROM.read(15);
  Message[7] = EEPROM.read(16);
  Message[8] = 0;
  uint8_t RadioType = EEPROM.read(17);
  Serialprint("\n\r{\"CD\":{");    //CD Configuration Dump
  Serialprint("\"cs\":%d,\"smj\":%d,\"smn\":%d,\"c\":\"%s\",\"m\":\"%s\",\"r\":%d,",Check,SW_major,SW_minor,CallSign,Message,RadioType);
  Serialprint("\"ful\":%d,\"fll\":%d,\"sul\":%d,\"sll\":%d,",freqLimits.trx_max_125,freqLimits.trx_min_125,freqLimits.scn_max_125,freqLimits.scn_min_125);
  Serialprint("\"AT\":%d,\"AM\":\"HEBELE\",\"AF\":%d,\"IF\":%d",APRS_Timeout,            freqLimits.aprs_125,freqLimits.iss_125);
  Serialprint("}}\n\r");
  Alert_Tone(SUCC_tone);
}


/*
 * Print the memory channels in form of JSON array to Serial Port
 */
void commandMemoryDump()
{
  Serialprint("\r\nMD[");    //Memory Dump
  for (int ch=1;ch<=50;ch++)
    {
      //channelInfo_t chInfo = 
      GetPrintMemoryChannelInfo(ch,true);
      Serialprint(",");
    }
    Serialprint("{}]\r\n");
}

void commandMemoryChannel()
{
  
    //H [Kanal_No #2] [isim #6] [Frekans #6] [Shift #5] [Ton #4]
    //Ornek:       H 01 ROLE-0 145600 +0600 0885

}

void commandAPRSTimeout()
{
  //Serialprint("OK\r\n");
  APRS_Timeout = commandString.substring(2,4).toInt();
  eeprom_writeAPRS();
  Alert_Tone(OK_tone);

}

void commandAPRSMessage()
{
  //Serial.print(commandString.substring(2,30));
  for (uint8_t cn=0;cn<28;cn++) APRS_Message[cn] = ((commandString[cn+2] >= 32) and (commandString[cn+2] <= 126)) ?  commandString[cn+2] : ' ';
  //Serial.print(APRS_Message);
  //Serialprint("OK\r\n");
  eeprom_writeAPRS();
  Alert_Tone(OK_tone);
}

void commandFrequencyLowerLimit()
{
  freqLimits.trx_min_125 = commandString.substring(2,5).toInt();
  EEPROM.put(EEPROM_SPECIALFRQ_BLCKSTART,freqLimits);
  Alert_Tone(OK_tone);
}

void commandFrequencyUpperLimit()
{
  freqLimits.trx_max_125 = commandString.substring(2,5).toInt();
  EEPROM.put(EEPROM_SPECIALFRQ_BLCKSTART,freqLimits);
  Alert_Tone(OK_tone);
}

void commandScanLowerLimit()
{
  freqLimits.scn_min_125 = commandString.substring(2,5).toInt();
  EEPROM.put(EEPROM_SPECIALFRQ_BLCKSTART,freqLimits);
  Alert_Tone(OK_tone);
}

void commandScanUpperLimit()
{
  freqLimits.scn_max_125 = commandString.substring(2,5).toInt();
  EEPROM.put(EEPROM_SPECIALFRQ_BLCKSTART,freqLimits);
  Alert_Tone(OK_tone);
}

void commandAprsFrequency()
{
  freqLimits.aprs_125 = commandString.substring(2,5).toInt();
  EEPROM.put(EEPROM_SPECIALFRQ_BLCKSTART,freqLimits);
  Alert_Tone(OK_tone);
}

void commandISSFrequency()
{
  freqLimits.iss_125 = commandString.substring(2,5).toInt();
  EEPROM.put(EEPROM_SPECIALFRQ_BLCKSTART,freqLimits);
  Alert_Tone(OK_tone);
}

void commandVNALowerLimit()
{
  freqLimits.vna_min_125 = commandString.substring(2,5).toInt();
  EEPROM.put(EEPROM_SPECIALFRQ_BLCKSTART,freqLimits);
  Alert_Tone(OK_tone);
}

void commandVNAUpperLimit()
{
  freqLimits.vna_max_125 = commandString.substring(2,5).toInt();
  EEPROM.put(EEPROM_SPECIALFRQ_BLCKSTART,freqLimits);
  Alert_Tone(OK_tone);
}

void getEEPROMData()
{
  int addr = commandString.substring(2,4).toInt();
  uint8_t eeprom_val;
  //Serialprint("currentch %d %d %d %d %d\r\n", current_ch.frequency,current_ch.shift, current_ch.shift_dir, current_ch.tone_pos, current_ch.tone_enabled);
  for (int tt=0;tt<10;tt++)
    {
    eeprom_val = EEPROM.read(addr+tt);
    Serialprint("DATA: %d = %d \r\n", addr+tt, eeprom_val);
    }
}

void commandAPRSmycall()
{
  //Serial.print(commandString.substring(2,8));
  mycall = commandString.substring(2,8);  
  eeprom_writeAPRS();
  //Serialprint(" OK\r\n");
  Alert_Tone(OK_tone);
}

void commandTogglePTT()
{
  pttToggler = !pttToggler; 
  if (pttToggler) Serialprint("TX\r\n");
  else Serialprint("RX\r\n");
}

int readColumn()
{
    Wire.beginTransmission(B0100000); //Here we're pushing VCC from one of PCF8574 and reading the other
    Wire.write(0); 
    Wire.endTransmission();
    Wire.beginTransmission(B0100001);
    Wire.write(255); 
    Wire.endTransmission();
    
    Wire.requestFrom(0x21,1);
    int c = Wire.read();
    c = 255 - c;
    int sutun = 0 ;
    if (c == 8) sutun = 0;
    if (c == 4) sutun = 1;
    if (c == 2) sutun = 2;
    if (c == 1) sutun = 3;

    

    return sutun;
}

int readRow()
{
    Wire.requestFrom(0x20,1);
    int r = Wire.read();    // receive a byte as character
    r = 255 - (r | B00000011) ; 
    r = r >> 3;
    int satir = 5;
    if (r == 16) satir = 0;
    if (r ==  8) satir = 1;
    if (r ==  4) satir = 2;
    if (r ==  2) satir = 3;
    if (r ==  1) satir = 4;
    
    return satir;
}

void StoreSpecialFrequency(char mCHNL[9], char mFRQ[9])
{
    uint16_t ChannelNumber = (((mCHNL[0] - 48) * 100) + ((mCHNL[1] - 48) * 10) + (mCHNL[2] - 48));
    if (Calculate_Frequency(mFRQ))
    {
      if (ChannelNumber == 101) { freqLimits.trx_min_125 = current_ch.frequency/12.5; } //TRX Lower Limit
      if (ChannelNumber == 151) { freqLimits.trx_min_125 = DEFAULT_VHF_MINIMUM_FREQ; }
      if (ChannelNumber == 102) { freqLimits.trx_max_125 = current_ch.frequency/12.5; } //TRX Upper Limit
      if (ChannelNumber == 152) { freqLimits.trx_max_125 = DEFAULT_VHF_MAXIMUM_FREQ; }
      if (ChannelNumber == 201) { freqLimits.scn_min_125 = current_ch.frequency/12.5; } //Scan lower Limit
      if (ChannelNumber == 202) { freqLimits.scn_max_125 = current_ch.frequency/12.5; } //Scan Upper Limit
      if (ChannelNumber == 301) { freqLimits.aprs_125    = current_ch.frequency/12.5; } //APRS Frequency
      if (ChannelNumber == 302) { freqLimits.iss_125     = current_ch.frequency/12.5; } //ISS APRS Frequency
      if (ChannelNumber == 401) { freqLimits.vna_min_125 = current_ch.frequency/12.5; } //VNA minimum frequency
      if (ChannelNumber == 402) { freqLimits.vna_max_125 = current_ch.frequency/12.5; } //VNA maximum frequency
      if (ChannelNumber <= 402) { EEPROM.put(EEPROM_SPECIALFRQ_BLCKSTART,freqLimits); }
      if (ChannelNumber == 600) { APRS_Timeout =  current_ch.frequency % 1000; eeprom_writeAPRS(); } //APRS Timeout
      if (ChannelNumber == 666) { initialize_eeprom(); } //initialize eeprom
      if (ChannelNumber == 667) { softResetDevice(); } //rest/reboot device
      if (ChannelNumber == 998) { radio_type = 1 ; initialize_eeprom(); } //Initiralize device
      if (ChannelNumber == 999) { radio_type = 0 ; initialize_eeprom(); } //Initiralize device
      if (ChannelNumber >= 998) { softResetDevice(); }
      Alert_Tone(SUCC_tone);
    }  

}


void startScan()
{


  unsigned long scan_frequency = 144000;
  int8_t frq_step = 25;
  while (1)
  {
        scan_frequency += frq_step;
        if (scan_frequency >= (freqLimits.scn_max_125*12.5)) scan_frequency = (freqLimits.scn_min_125*12.5);
        else if (scan_frequency <= (freqLimits.scn_min_125*12.5)) scan_frequency = (freqLimits.scn_max_125*12.5);

        numberToFrequency(scan_frequency,FRQ);
        validFRQ = Calculate_Frequency(FRQ);
        write_FRQ(current_ch.frequency);
        writeFRQToLcd(FRQ);
        //Serialprint(">%d\t",scan_freq);
        delay(100);
        CHANNEL_BUSY = digitalRead(SQL_ACTIVE);  
        //int sutun = readColumn();
        //int satir = readRow();
        //Serialprint("keypres= %d %d \r\n",sutun,satir);
        if (CHANNEL_BUSY == 0) break;
        if (readColumn() != 0) break;
  }

}


void setup() {
  wdt_enable(WDTO_4S);
//pin modes and initial states
  pinMode(SQL_ACTIVE, INPUT);
  digitalWrite(SQL_ACTIVE, SQL_ON); //Disable squelch for startup
  pinMode(MIC_PIN, OUTPUT);

  pinMode(RF_POWER_PIN, OUTPUT); //RF power control is output
  digitalWrite(RF_POWER_PIN, RF_POWER_STATE);
  //TODO: store last power state and restore on every boot 
  
  pinMode(MUTE_PIN_1, OUTPUT);
  digitalWrite(MUTE_PIN_1, HIGH); //Mute the Audio output

  pinMode(BAND_SELECT_0, OUTPUT);
  pinMode(BAND_SELECT_1, OUTPUT);

  pinMode(PTT_INPUT_PIN,  INPUT_PULLUP);
  pinMode(PTT_OUTPUT_PIN, OUTPUT);
  digitalWrite(PTT_OUTPUT_PIN, LOW); //No PTT at startup

  pinMode(FWD_POWER_PIN, INPUT);
  pinMode(REF_POWER_PIN, INPUT);

  //pinMode(KeypadIntPin,    INPUT);
	pinMode(KeypadIntPin, INPUT_PULLUP);
 // attachPinChangeInterrupt(KeypadIntPin, KeyPadInterrupt, RISING);						   
  pinMode(pll_clk_pin, OUTPUT);
  pinMode(pll_data_pin,OUTPUT);
  pinMode(pll_ena_pin, OUTPUT);
  pinMode(PLL_SEC, OUTPUT);

  digitalWrite(pll_clk_pin, LOW);
  digitalWrite(pll_data_pin,LOW);
  digitalWrite(pll_ena_pin, LOW);

  cli(); // Turn Off Interrupts
  //PCICR  |= 0b00000100;  
  PCICR = (1 << PCIE2);  //same as above but different :)
 // PCMSK1 |= 0b00010000; // PCINT20 - Digital 4 Pin
 // PCMSK2 |= 0b00010000; // PCINT20 - Digital 4 Pin
  PCMSK2 |= (1 << PCINT20); //same as above but different :)
  sei();
  delay(100);

  Serial.begin(115200);
  commandString.reserve(200);

  // Check EEPROM for stored values
  uint8_t eeprom_state=0;
 // EEPROM.write(0,127);
  eeprom_state = EEPROM.read(0);//EEPROM Check For Modification Board
  //Serialprint("ACILIS DEGERI %d\r\n",eeprom_state);
  if (eeprom_state != 127) initialize_eeprom();
  // if (eeprom_state != 127) Serialprint("EEPROM Sifirlaniyor \n\r");
  radio_type = EEPROM.read(17);//UHF VHF Seçimi
  //Serialprint("CIHAZ TIPI %d\r\n",radio_type);
  if (EEPROM.read(1) != SW_MAJOR or EEPROM.read(2) != SW_MINOR) initialize_eeprom();
  //Serialprint("MAJOR %d MINOR %d\r\n",EEPROM.read(1),EEPROM.read(2));

  eeprom_readAPRS();

  EEPROM.get(EEPROM_CURRCHNL_BLCKSTART, current_ch);
  numberToFrequency(current_ch.frequency, FRQ);
  strcpy(FRQ_old,FRQ);
 
  SetTone(current_ch.tone_enabled);

  EEPROM.get(EEPROM_SPECIALFRQ_BLCKSTART,freqLimits);

  EEPROM.get(EEPROM_TOT, tot_values);

  //setRadioPower();  //Check power switch mode and turn adio on immediately
  //pinMode(POWER_ON_OFF, INPUT);
  //pinMode(POWER_ON_PIN, OUTPUT);
 
  memset(matrix, 0, 24);
  Wire.begin(); 
  delay(100);  // Give some time to boot

  // Init LCD
  InitLCD();
  Greetings();

  writeFRQToLcd(FRQ);
  
  old_KeyVal = 1; //initial keypad read
  validFRQ = Calculate_Frequency(FRQ); // start with default frequency //TODO: Change this to last frequemcy set

  scrTimer = TimeoutValue;  

  if (pgm_read_byte (32700) != 188)
   while (1) 
    Alert_Tone(ERR_tone);

  PrintMenu();
}


void loop() {

  //setRadioPower(); //Check power switch and set radio power mode on or off
  
  //if (scrMODE==scrNORMAL) writeFRQToLcd(FRQ); //TODO: We should update the display only on proper display changes.. But this works...

  if (scrMODE==scrNORMAL)
  {
    if (TRX_MODE == TX) 
    {
      numberToFrequency(current_ch.frequency+current_ch.shift_dir*current_ch.shift,FRQ_old); 
      writeFRQToLcd(FRQ_old);
    } else
    {
      writeFRQToLcd(FRQ);
    }
  }


  //Output data to Keyboard... First first bits for keyboard, next bits for backlight and leds... 
  Wire.beginTransmission(PCF8574_KEYB_LED);
  Led_Status = 240;
  if ((CHANNEL_BUSY==0) or (SQL_MODE==SQL_OFF)) Led_Status = Led_Status - green_led; //we are receivig
  if (CHANNEL_BUSY==0) APRS_Counter = 0; //If channel is busy, dont transmit APRS, wait the musy to finish and restart counter
  if (TRX_MODE == TX) Led_Status = Led_Status - red_led;  //We are transmitting
  if (pttToggler) send_packet(_STATUS,(freqLimits.aprs_125*12.5)); //TODO: what if UHF

  //Led_Status = Led_Status - yellow_led;
  //Led_Status = Led_Status - red_led;
  if (APRS_Counter < 2000) Led_Status = Led_Status - backlight;
  Wire.write(Led_Status); 
  Wire.endTransmission();

  CHANNEL_BUSY = digitalRead(SQL_ACTIVE);  
  if (CHANNEL_BUSY == 0) digitalWrite(MUTE_PIN_1, LOW);
    else if (SQL_MODE == SQL_ON) digitalWrite(MUTE_PIN_1, HIGH); 
      else digitalWrite(MUTE_PIN_1, LOW);


  /*
  TOT Function
  Call Method.
  */
  TRX_MODE =  TXTimeOutTimer(digitalRead(PTT_INPUT_PIN)); //read PTT state
  if (TOT_FLAG == 1) {
    writeToLcd("TOTWARN ");
    delay(10);
    if (TOT_WARN_STATE == 1) Alert_Tone(ERR_tone);
    TOT_WARN_STATE = 0;
  }


//TRX_MODE = digitalRead(PTT_INPUT_PIN); //read PTT state
//  if (pttToggler && TRX_MODE == RX) TRX_MODE = TX; //if pttToggler set from serial, then mode is transmission
  if (TRX_MODE != LST_MODE) {
    LST_MODE = TRX_MODE;
    write_FRQ(current_ch.frequency); //Update frequency on every state change
  }
  if (TRX_MODE == TX ) digitalWrite(PTT_OUTPUT_PIN,HIGH); // now start transmitting
    else digitalWrite(PTT_OUTPUT_PIN, LOW);

  SetTone(current_ch.tone_enabled); //Change Tone Generation State

  //if (subMENU == menuRPT) writeToLcd(cstr);

 //check APRS timer timeout, and send APRS message if timeout reached
 //TODO: Convert timeout to seconds instead of loop counter
  APRS_Counter += 1;
  //if (APRS_Counter % 1000) Serialprint("%d\r\n",APRS_Counter);
  //uint32_t APR_tmt = APRS_Timeout * 60 * 150;
  if (((APRS_Counter/150) >= (APRS_Timeout)) && (APRS_Timeout > 0)) {
     send_packet(_FIXPOS_STATUS,(freqLimits.aprs_125*12.5)); //For APRS terrestrial  //TODO: UHF ?
     send_packet(_FIXPOS_STATUS,(freqLimits.iss_125*12.5));  //For ISS               //TODO: UHF ?
     APRS_Counter = 0;
  }

  //this is our interrupt pin... Move this to a proper interrupt rutine
  KeyVal = digitalRead(KeypadIntPin);


  //Long press on a key detection...
  if ((KeyVal == old_KeyVal) & (KeyVal ==  0) & (scrTimer>0)) scrTimer -= 1; //Keypressed and there are counts to go
    else if (KeyVal==1) {
     if (scrTimer==0) { //key released and timeout occured
//       writeToLcd("SELECT   ");
//       delay(500); //TODO do not use DELAY, change to a timer
       if (pressedKEY=='B') { writeToLcd("TONE     "); subMENU = menuTONE; delay(1000);write_TONEtoLCD(current_ch.tone_pos); old_ctcss_tone_pos = current_ch.tone_pos;}
       if (pressedKEY=='S') { writeToLcd("SQL      "); subMENU = menuSQL;  }
       if (pressedKEY=='O') { writeToLcd("SCAN     "); delay(1000); startScan(); } //subMENU = menuSCAN; }
       if (pressedKEY=='R') { writeToLcd("SHIFT    "); subMENU = menuRPT;  delay(1000);write_SHIFTtoLCD(current_ch.shift); old_frqSHIFT=current_ch.shift;}
       if (pressedKEY=='M') { writeToLcd("MENU     "); subMENU = menuMENU; }
       delay(500); //TODO do not use DELAY, change to a timer
       scrTimer = TimeoutValue; //Restart the timer
       numChar = 0; //if we were entering frq from keyboard
       scrMODE = scrMENU;    
     }//scrTimer
    }//Keyval==0

  
  if (KeyVal != old_KeyVal) { 
    if (KeyVal == 0) Alert_Tone(OK_tone);  

    APRS_Counter = 0; //if a key is pressed, restart the APRS timer

    scrTimer = TimeoutValue; //Restart the timer

    int satir = readRow();
    int sutun = readColumn();
    pressedKEY = keymap[sutun][satir]; //LOOKUP for the pressedKEY
    // Serialprint("set keyboard pressedKey:%d \n\r  ", pressedKEY);
    
  /* -----------------------------------------------------
     SCREEN MODE MENU..  
     ----------------------------------------------------- */

    if (scrMODE == scrMENU)  {
      // Serialprint("srcmode src menu \n\r  ");
      if (pressedKEY != 'X') {
        // Serialprint("src menu not X pressedKey:%d \n\r  ", pressedKEY);
        switch (pressedKEY) {
          case 'U':
            if ( subMENU == menuRPT)  { current_ch.shift += 25; write_SHIFTtoLCD(current_ch.shift); }  //TODO: check overflows... + or -
            if ( subMENU == menuTONE) { current_ch.tone_pos += 1; if (current_ch.tone_pos>=19) current_ch.tone_pos = 19 ; write_TONEtoLCD(current_ch.tone_pos); EEPROM.put(EEPROM_CURRCHNL_BLCKSTART, current_ch);}
            break;
          case 'D':
            if ( subMENU == menuRPT)  {current_ch.shift -= 25; write_SHIFTtoLCD(current_ch.shift); }
            if ( subMENU == menuTONE) { current_ch.tone_pos -= 1;  if (current_ch.tone_pos<=0) current_ch.tone_pos = 0 ; write_TONEtoLCD(current_ch.tone_pos); EEPROM.put(EEPROM_CURRCHNL_BLCKSTART, current_ch);}
            break;
          case '#': //means CANCEL
            if (subMENU == menuRPT)  current_ch.shift = old_frqSHIFT;
            if (subMENU == menuTONE) current_ch.tone_pos = old_ctcss_tone_pos;
            //testing the lock reported by TA2GY .. memory recall after shift setup locks device
            numChar = 0;
            // Serialprint("set to X pressedKey:%d \n\r  ", pressedKEY);
            pressedKEY = 'X';
            scrMODE = scrNORMAL; //we are in menu or submenus.. return to normal display
            subMENU = menuNONE;
          break; // '#'
          case '*': //means OK
            EEPROM.put(EEPROM_CURRCHNL_BLCKSTART, current_ch);
            //if ( subMENU == menuRPT)  write_SHIFTtoEE(frqSHIFT);
            //if ( subMENU == menuTONE) write_TONEtoEE(ctcss_tone_pos);
            //testing the lock reported by TA2GY .. memory recall after shift setup locks device
            numChar = 0;
            // Serialprint("set to X * pressedKey:%d \n\r  ", pressedKEY);
            pressedKEY = 'X';
            scrMODE = scrNORMAL; //we are in menu or submenus.. return to normal display
            subMENU = menuNONE;
          break; // '*'
          default:
          break; 
        }//switch
      }//pressedKEY!='X'
    }//scrMENU
    
  /* -----------------------------------------------------
   SCREEN MODE NORMAL.. WE READ FREQUENCY AND OTHER KEYS 
   ----------------------------------------------------- */
    if (scrMODE == scrNORMAL) { //mode NORMAL and key released
      // Serialprint("src normal pressedKey:%d \n\r  ", pressedKEY);
      if (pressedKEY != 'X') {
        // Check for the COMMAND keys first
        switch (pressedKEY) {
          case 'R':
            if (current_ch.shift_dir == noSHIFT) { 
              current_ch.shift_dir = plusSHIFT;
            } else if (current_ch.shift_dir == plusSHIFT) {
              current_ch.shift_dir = minusSHIFT;
            } else { 
              current_ch.shift_dir = noSHIFT;
            }
            EEPROM.put(EEPROM_CURRCHNL_BLCKSTART, current_ch);
          break; //'R'
          case 'B':
            if (current_ch.tone_enabled == CTCSS_OFF) {
              current_ch.tone_enabled = CTCSS_ON;
            } else {
              current_ch.tone_enabled = CTCSS_OFF;
            }
            EEPROM.put(EEPROM_CURRCHNL_BLCKSTART, current_ch);    
            SetTone(current_ch.tone_enabled); //Change Tone Generation State
          break; // 'B'
          case 'S':
            if (SQL_MODE == SQL_OFF) {
              SQL_MODE = SQL_ON;
            } else {
              SQL_MODE = SQL_OFF;
            }
          break; //'S'
          case 'O':
             if (RF_POWER_STATE == HIGH_POWER) {
                RF_POWER_STATE = LOW_POWER;
             } else {
                RF_POWER_STATE = HIGH_POWER;
             }
//             SetRFPower(RF_POWER_STATE);           
             SetRFPower();           
          break; //'O'
          case 'U':
            numberToFrequency(current_ch.frequency+25,FRQ);
            Calculate_Frequency(FRQ);  
            write_FRQ(current_ch.frequency); 
            //TODO: write to eeprom
          break; // 'U' 
          case 'D':
            numberToFrequency(current_ch.frequency-25,FRQ);
            Calculate_Frequency(FRQ);  
            write_FRQ(current_ch.frequency);           
            //TODO: write to eeprom
          break; // 'D'
          case 'M': //Reverse
            numberToFrequency(current_ch.frequency+current_ch.shift_dir*current_ch.shift,FRQ);
            if (current_ch.shift_dir == plusSHIFT) { 
              current_ch.shift_dir = minusSHIFT;
            } else if (current_ch.shift_dir == minusSHIFT) {
              current_ch.shift_dir = plusSHIFT;
            } 
            Calculate_Frequency(FRQ);  
            write_FRQ(current_ch.frequency);           

           //Serialprint(pressedKEY);
          break; // 'M'
          case 'C':
            //VNA Vector Network analizor Subroutines
            TRX_MODE = TX; //needed for PLL locking to TX frequrency
            minSWR = 9999;
            lowestFRQ=0;
            highestFRQ=0;           
            //TODO: Store old values of variables (FRQ, SHIFT, etc)
            //TODO: Put transmitter on low power before operation
            //TODO: If any key pressed cancel VNA operation
            strcpy(FRQ_old,FRQ); //store old frequency for recall
            current_ch.shift_dir = noSHIFT; //get into SIMPLEX mode for caculations
//            SetRFPower(LOW_POWER);
            SetRFPower();
            long min_vna_freq;
            long max_vna_freq;
            int  stp_vna_freq;
            if (radio_type==0)
            {
              min_vna_freq = freqLimits.vna_min_125 * 12.5;
              max_vna_freq = freqLimits.vna_max_125 * 12.5;
              stp_vna_freq = 10;
            }
            else //TODO: different defaults for VHF and UHF
            {
              min_vna_freq = 43000;
              max_vna_freq = 45000;              
              stp_vna_freq = 10;
            }
            digitalWrite(PTT_OUTPUT_PIN,HIGH);
            Serialprint("\r\n#VNA#\t%l\t%l\r\n",min_vna_freq,max_vna_freq); //START
            for (long vna_freq=min_vna_freq; vna_freq < max_vna_freq; vna_freq += stp_vna_freq)
              {
                numberToFrequency(vna_freq,FRQ);
                validFRQ = Calculate_Frequency(FRQ);
                write_FRQ(current_ch.frequency);
                writeFRQToLcd(FRQ);
                Serialprint(">%d\t",vna_freq);
                delay(100);
                //digitalWrite(PTT_OUTPUT_PIN,HIGH);
                //delay(50);
                readRfPower(); //TODO: Move under a menu item
                //delay(25);
                //digitalWrite(PTT_OUTPUT_PIN,LOW);

                if (readColumn() != 0) break; //a key is pressed
              }
              digitalWrite(PTT_OUTPUT_PIN,LOW);
              Serialprint("@VNA@\t%d\t%d\r\n",min_vna_freq,max_vna_freq); //END
              //SetRFPower(RF_POWER_STATE);
              SetRFPower();
              TRX_MODE = RX; //PLL should lock to RX
              //strcpy(FRQ,FRQ_old);
              numberToFrequency((highestFRQ+lowestFRQ)/2,FRQ);
              validFRQ = Calculate_Frequency(FRQ);
              write_FRQ(current_ch.frequency);            
              writeFRQToLcd(FRQ);
              PrintMenu(); //print menu for user selection  
          break; // 'C'
          case '#':
            if (numChar == 2) StoreFrequency(FRQ,FRQ_old); // User is trying to store the actual frequency : FRQ[0..1] ccontains memory channel and FRQ_old contains the frequency to be stored
            if (numChar == 4) StoreSpecialFrequency(FRQ,FRQ_old);
            strcpy(FRQ,FRQ_old);
            validFRQ = Calculate_Frequency(FRQ);
            numChar = 0;
            write_FRQ(current_ch.frequency);
          break; // '#'
          case '*':
            if (numChar == 2) GetMemoryChannel(FRQ); // User wanted to retrieve the memory channel from EEPRM
            else strcpy(FRQ,FRQ_old); // Otherwise user wanted to cancel the ongoing operation.. return to previous (old) frequency
            validFRQ = Calculate_Frequency(FRQ);
            numChar = 0;
            write_FRQ(current_ch.frequency);
          break; // '*'
         
          default:  
            /* ------------------    FRQ INPUT ------------ */
            // Serialprint("Before If FRQ :%s numChar:%d pressedKey:%d \n\r  ",FRQ,numChar,pressedKEY);
            if (numChar <= 6) { //Not a command Key so print it into frequency
              if (numChar == 0) {
              //  strcpy(FRQ,"        "); //just pressed keys, so clear the screen
              FRQ[0]=' ';
              FRQ[1]=' ';
              FRQ[2]=' ';
              FRQ[3]=' ';
              FRQ[4]=' ';
              FRQ[5]=' ';
              FRQ[6]=' ';
              FRQ[7]=' ';
              }
              
              FRQ[numChar] = pressedKEY;
              numChar = numChar + 1;
              if (numChar == 3) { //place a dot for the 4th character
                FRQ[3] = '.';
                numChar = numChar + 1;
              } //numchar==3
              
              if (numChar == 7) { //input finished 
                validFRQ = Calculate_Frequency(FRQ);
                numChar = 0;
                write_FRQ(current_ch.frequency);
                if (validFRQ) {
                  strcpy(FRQ_old,FRQ);
                } else {
                  strcpy(FRQ,FRQ_old); //"   .   ";
                  numChar = 0;
                  validFRQ = Calculate_Frequency(FRQ);
                  write_FRQ(current_ch.frequency);
                  //sound audible error here
                }
              } // numChar==7
            }//numchar<6
            
          break; 
        }
      }//pressedKEY != 'X'    
    } //scrMODE=scrNORMAL
    //Put 8574_ into READ mode by setting ports high
    Wire.beginTransmission(0x20);
    Wire.write(255); 
    Wire.endTransmission();
    //Toggle interupt PIN state holder
    old_KeyVal = KeyVal;
   } //KeyVal!=old_keyval

if (commandComplete) {
    //TODO: convert to case/switch
    if (commandString.charAt(0) == '\n') PrintMenu();
    //if (commandString.charAt(0) == 'Y') commandYardim(commandString.charAt(2));
    if (commandString.charAt(0) == 'C') commandRadioType(commandString.charAt(2));
    if (commandString.charAt(0) == 'A') commandStartupMSG();
    if (commandString.charAt(0) == 'T') commandAPRSTimeout();
    if (commandString.charAt(0) == 'M') commandAPRSMessage();    
    if (commandString.charAt(0) == 'S') commandAPRSmycall();    
    if (commandString.charAt(0) == 'H') commandMemoryDump();
    if (commandString.charAt(0) == 'K') commandDumpConfig();
    if (commandString.charAt(0) == 'C') commandMemoryChannel();
    if (commandString.charAt(0) == 'P') commandTogglePTT();
    if (commandString.charAt(0) == 'G') getGPSData();
    if (commandString.charAt(0) == 'R') getEEPROMData();
    if (commandString.charAt(0) == 'N') startScan();
    if (commandString.charAt(0) == 'X') softResetDevice();
    if (commandString.charAt(0) == 'f') commandFrequencyLowerLimit();
    if (commandString.charAt(0) == 'F') commandFrequencyUpperLimit();
    if (commandString.charAt(0) == 'q') commandScanLowerLimit();
    if (commandString.charAt(0) == 'Q') commandScanUpperLimit();
    if (commandString.charAt(0) == 'B') commandAprsFrequency();
    if (commandString.charAt(0) == 'I') commandISSFrequency();
    
//   Serial.println("Gecersiz bir komut... tekrar deneyiniz...");
    commandString = "";
    commandComplete = false;
    PrintMenu();
    //Serialprint("\r\nSeciminiz>");
    //EEPROM.get(EEPROM_CURRCHNL_BLCKSTART, current_ch);
  }

//13:49:03$ fm TA7W-9 to TAMSAT-0 via ARISS-1 UI  PID=F0!3955.50N>3250.22E/ TAMSAT KIT - APRS TEST
//  send_packet(_STATUS);  
//  delay(tx_delay);
//  randomize(tx_delay, 10, 5000);
//  randomize(str_len, 10, 420);
  #ifdef RESETWATCHDOG
	wdt_reset();
  #endif
} //loop

void StreamPrint_progmem(Print &out,PGM_P format,...)
{
  #ifdef SERIALMENU 
  char formatString[128], *ptr;
  strncpy_P( formatString, format, sizeof(formatString) ); // copy in from program mem
  // null terminate - leave last char since we might need it in worst case for result's \0
  formatString[ sizeof(formatString)-2 ]='\0'; 
  ptr=&formatString[ strlen(formatString)+1 ]; // our result buffer...
  va_list args;
  va_start (args,format);
  vsnprintf(ptr, sizeof(formatString)-1-strlen(formatString), formatString, args );
  va_end (args);
  formatString[ sizeof(formatString)-1 ]='\0'; 
  out.print(ptr);
  #endif
}


void serialEvent() {
  //Serialprint(".");
  cli();
  while (Serial.available()) {
    //char inChar = UDR0; //
    char inChar = (char)Serial.read();
    //Serialprint(inChar); //local echo
    commandString += inChar;
    if (inChar == '\n') {
      commandComplete = true;
    }
  }
  sei();
}

/*
 * seri olarak okunan byte lari 0x09 veya 0x04 e kadar olanini geri dondurmek icin
 */
/*
void readParam(char *szParam, int iMaxLen) {
  uint8_t c;
  int iSize;
  unsigned long iMilliTimeout = millis() + 2000; 

  for (iSize=0; iSize<iMaxLen; iSize++) szParam[iSize] = 0x00; 
  iSize = 0;   

  while (millis() < iMilliTimeout) {

    if (Serial.available()) {
      c = Serial.read();

      if (c == 0x09 || c == 0x04) {
        Serialprint("\r\n");
        return;
      }
      if (iSize < iMaxLen) {
        szParam[iSize] = c;
        iSize++;
      }
    }
  }

}

bool getFromSerialport() {
  char szParam[10]; //maximum length of a variable value
  unsigned long iMilliTimeout = millis() + 10000;    
  while (millis() < iMilliTimeout) {
  while (!Serial.available()) { } 
    if (Serial.read() == 0x01) {   //The stream starts with a 0x01
      readParam(szParam, sizeof(szParam));
      if (strcmp(szParam, VERSIYON) != 0) {
        DEBUG_PORT.println(szParam);
          DEBUG_PORT.println(F("E99 Versiyonlar uyumsuz..."));
        return false;
      }
    
      readParam(szParam, sizeof(Ayarlar.APRS_CagriIsareti));    //CagriIsareti
      strcpy(Ayarlar.APRS_CagriIsareti, szParam);
      readParam(szParam, 1);    //CagriIsareti SSID
      Ayarlar.APRS_CagriIsaretiSSID = szParam[0];


      readParam(szParam, sizeof(Ayarlar.APRS_Destination));    //Destination
      strcpy(Ayarlar.APRS_Destination, szParam);
      readParam(szParam, 1);    //SSID
      Ayarlar.APRS_DestinationSSID = szParam[0];

      readParam(szParam, sizeof(Ayarlar.APRS_Path1));    //Path1
      strcpy(Ayarlar.APRS_Path1, szParam);
      readParam(szParam, 1);    //SSID
      Ayarlar.APRS_Path1SSID = szParam[0];

      readParam(szParam, sizeof(Ayarlar.APRS_Path2));    //Path2
      strcpy(Ayarlar.APRS_Path2, szParam);
      readParam(szParam, 1);    //SSID
      Ayarlar.APRS_Path2SSID = szParam[0];

      //Symbol/Tab
      readParam(szParam, 1);
      Ayarlar.APRS_Sembolu = szParam[0];
      readParam(szParam, 1);
      Ayarlar.APRS_SembolTabi = szParam[0];

      //BeaconTipi
      readParam(szParam, sizeof(szParam));
      Ayarlar.APRS_BeaconTipi = atoi(szParam);

      //Beacon Suresi
      readParam(szParam, sizeof(szParam));
      Ayarlar.APRS_BeaconSuresi = atoi(szParam);

      //GPS Seri Hizi
      readParam(szParam, sizeof(szParam));
      Ayarlar.APRS_GPSSeriHizi = atoi(szParam);

      //Status Message
      readParam(szParam, sizeof(szParam));
      strcpy(Ayarlar.APRS_Message, szParam);

      //GPS Var/Yok
      readParam(szParam, sizeof(szParam));
      Ayarlar.gps_varyok = atoi(szParam);    



      unsigned int iCheckSum = 0;
      for (int i=0; i<7; i++) {
        iCheckSum += Ayarlar.APRS_CagriIsareti[i];
      }
      Ayarlar.CheckSum = iCheckSum;
      return true;    //OKuma tamamlandi
    } // read 0x01
  } //millis
  return false;

}
*/


/*
 * 
 */
void set_nada_1200(void)
{
  digitalWrite(MIC_PIN, HIGH);
  delayMicroseconds(tc1200);
  digitalWrite(MIC_PIN, LOW);
  delayMicroseconds(tc1200);
}

void set_nada_2400(void)
{
  digitalWrite(MIC_PIN, HIGH);
  delayMicroseconds(tc2400);
  digitalWrite(MIC_PIN, LOW);
  delayMicroseconds(tc2400);
  
  digitalWrite(MIC_PIN, HIGH);
  delayMicroseconds(tc2400);
  digitalWrite(MIC_PIN, LOW);
  delayMicroseconds(tc2400);
}

void set_nada(bool nada)
{
  if(nada)
    set_nada_1200();
  else
    set_nada_2400();
}

/*
 * This function will calculate CRC-16 CCITT for the FCS (Frame Check Sequence)
 * as required for the HDLC frame validity check.
 * 
 * Using 0x1021 as polynomial generator. The CRC registers are initialized with
 * 0xFFFF
 */
void calc_crc(bool in_bit)
{
  unsigned short xor_in;
  
  xor_in = crc ^ in_bit;
  crc >>= 1;

  if(xor_in & 0x01)
    crc ^= 0x8408;
}

void send_crc(void)
{
  unsigned char crc_lo = crc ^ 0xff;
  unsigned char crc_hi = (crc >> 8) ^ 0xff;

  send_char_NRZI(crc_lo, HIGH);
  send_char_NRZI(crc_hi, HIGH);
}

void send_header(void)
{
  char temp;

  /*
   * APRS AX.25 Header 
   * ........................................................
   * |   DEST   |  SOURCE  |   DIGI   | CTRL FLD |    PID   |
   * --------------------------------------------------------
   * |  7 bytes |  7 bytes |  7 bytes |   0x03   |   0xf0   |
   * --------------------------------------------------------
   * 
   * DEST   : 6 byte "callsign" + 1 byte ssid
   * SOURCE : 6 byte your callsign + 1 byte ssid
   * DIGI   : 6 byte "digi callsign" + 1 byte ssid
   * 
   * ALL DEST, SOURCE, & DIGI are left shifted 1 bit, ASCII format.
   * DIGI ssid is left shifted 1 bit + 1
   * 
   * CTRL FLD is 0x03 and not shifted.
   * PID is 0xf0 and not shifted.
   */

  /********* DEST ***********/
  temp = strlen(dest);
  for(int j=0; j<temp; j++)
    send_char_NRZI(dest[j] << 1, HIGH);
  if(temp < 6)
  {
    for(int j=0; j<(6 - temp); j++)
      send_char_NRZI(' ' << 1, HIGH);
  }
  send_char_NRZI('0' << 1, HIGH);

  
  /********* SOURCE *********/
  temp = mycall.length();
  for(int j=0; j<temp; j++)
    send_char_NRZI(mycall[j] << 1, HIGH);
  if(temp < 6)
  {
    for(int j=0; j<(6 - temp); j++)
      send_char_NRZI(' ' << 1, HIGH);
  }
  send_char_NRZI((myssid + '0') << 1, HIGH);

  
  /********* DIGI ***********/
  temp = strlen(digi);
  for(int j=0; j<temp; j++)
    send_char_NRZI(digi[j] << 1, HIGH);
  if(temp < 6)
  {
    for(int j=0; j<(6 - temp); j++)
      send_char_NRZI(' ' << 1, HIGH);
  }
  send_char_NRZI(((digissid + '0') << 1) + 1, HIGH);

  /***** CTRL FLD & PID *****/
  send_char_NRZI(_CTRL_ID, HIGH);
  send_char_NRZI(_PID, HIGH);
}

void send_payload(char type)
{
  /*
   * APRS AX.25 Payloads
   * 
   * TYPE : POSITION
   * ........................................................
   * |DATA TYPE |    LAT   |SYMB. OVL.|    LON   |SYMB. TBL.|
   * --------------------------------------------------------
   * |  1 byte  |  8 bytes |  1 byte  |  9 bytes |  1 byte  |
   * --------------------------------------------------------
   * 
   * DATA TYPE  : !
   * LAT        : ddmm.ssN or ddmm.ssS
   * LON        : dddmm.ssE or dddmm.ssW
   * 
   * 
   * TYPE : STATUS
   * ..................................
   * |DATA TYPE |    STATUS TEXT      |
   * ----------------------------------
   * |  1 byte  |       N bytes       |
   * ----------------------------------
   * 
   * DATA TYPE  : >
   * STATUS TEXT: Free form text
   * 
   * 
   * TYPE : POSITION & STATUS
   * ..............................................................................
   * |DATA TYPE |    LAT   |SYMB. OVL.|    LON   |SYMB. TBL.|    STATUS TEXT      |
   * ------------------------------------------------------------------------------
   * |  1 byte  |  8 bytes |  1 byte  |  9 bytes |  1 byte  |       N bytes       |
   * ------------------------------------------------------------------------------
   * 
   * DATA TYPE  : !
   * LAT        : ddmm.ssN or ddmm.ssS
   * LON        : dddmm.ssE or dddmm.ssW
   * STATUS TEXT: Free form text
   * 
   * 
   * All of the data are sent in the form of ASCII Text, not shifted.
   * 
   */
  if(type == _FIXPOS)
  {
    send_char_NRZI(_DT_POS, HIGH);
    send_string_len(lat, lat.length());
    send_char_NRZI(sym_ovl, HIGH);
    send_string_len(lon, lon.length());
    send_char_NRZI(sym_tab, HIGH);
  }
  else if(type == _STATUS)
  {
    send_char_NRZI(_DT_STATUS, HIGH);
    send_string_len(APRS_Message, APRS_Message.length());
  }
  else if(type == _FIXPOS_STATUS)
  {
    send_char_NRZI(_DT_POS, HIGH);
    send_string_len(lat, lat.length());
    send_char_NRZI(sym_ovl, HIGH);
    send_string_len(lon, lon.length());
    send_char_NRZI(sym_tab, HIGH);

    send_char_NRZI(' ', HIGH);
    send_string_len(APRS_Message, APRS_Message.length());
  }
}

/*
 * This function will send one byte input and convert it
 * into AFSK signal one bit at a time LSB first.
 * 
 * The encode which used is NRZI (Non Return to Zero, Inverted)
 * bit 1 : transmitted as no change in tone
 * bit 0 : transmitted as change in tone
 */
void send_char_NRZI(unsigned char in_byte, bool enBitStuff)
{
  bool bits;
  
  for(int i = 0; i < 8; i++)
  {
    bits = in_byte & 0x01;

    calc_crc(bits);

    if(bits)
    {
      set_nada(nada);
      bit_stuff++;

      if((enBitStuff) && (bit_stuff == 5))
      {
        nada ^= 1;
        set_nada(nada);
        
        bit_stuff = 0;
      }
    }
    else
    {
      nada ^= 1;
      set_nada(nada);

      bit_stuff = 0;
    }

    in_byte >>= 1;
  }
}

void send_string_len(String in_string, int len)
{
  for(int j=0; j<len; j++)
    send_char_NRZI(in_string[j], HIGH);
}

void send_flag(unsigned char flag_len)
{
  for(int j=0; j<flag_len; j++)
    send_char_NRZI(_FLAG, LOW); 
}

/*
 * In this preliminary test, a packet is consists of FLAG(s) and PAYLOAD(s).
 * Standard APRS FLAG is 0x7e character sent over and over again as a packet
 * delimiter. In this example, 100 flags is used as the preamble and 3 flags as
 * the postamble.
 */
void send_packet(char packet_type, uint32_t frequency)
{
  /*
   * AX25 FRAME
   * 
   * ........................................................
   * |  FLAG(s) |  HEADER  | PAYLOAD  | FCS(CRC) |  FLAG(s) |
   * --------------------------------------------------------
   * |  N bytes | 22 bytes |  N bytes | 2 bytes  |  N bytes |
   * --------------------------------------------------------
   * 
   * FLAG(s)  : 0x7e
   * HEADER   : see header
   * PAYLOAD  : 1 byte data type + N byte info
   * FCS      : 2 bytes calculated from HEADER + PAYLOAD
   */

   strcpy(FRQ_old,FRQ); //store old frequency for recall
   current_ch.shift_dir = noSHIFT; //get into SIMPLEX mode for caculations
   TRX_MODE = TX;
   numberToFrequency(frequency,FRQ);         //TODO: change for ISS
   validFRQ = Calculate_Frequency(FRQ);
   write_FRQ(current_ch.frequency);
   writeFRQToLcd(FRQ);
   digitalWrite(PTT_OUTPUT_PIN,HIGH);
   //Serialprint("Sending packet..."); 
   noTone(MIC_PIN);
   delay(300); //TODO: put define for TXDELAY
    
  //prepare and send APRS message
  send_flag(100);
  crc = 0xffff;
  send_header();
  send_payload(packet_type);
  send_crc();
  send_flag(3);

  //APRS message transmission ended
  digitalWrite(PTT_OUTPUT_PIN,LOW); // now stop transmitting
  //Restoring OLD values
  TRX_MODE = RX;
  strcpy(FRQ,FRQ_old);
  //numberToFrequency((highestFRQ+lowestFRQ)/2,FRQ);
  validFRQ = Calculate_Frequency(FRQ);
  write_FRQ(current_ch.frequency);              
}

/*
 * Function to randomized the value of a variable with defined low and hi limit value.
 * Used to create random AFSK pulse length.
 */
 /*
void randomize(unsigned int &var, unsigned int low, unsigned int high)
{
  var = random(low, high);
}
*/

void getGPSData()
{
  TinyGPS gps;
  SoftwareSerial ss(A1, A3);
  ss.begin(9600);
  float flat, flon;
  unsigned long age = 0;
  //unsigned long age, date, time, chars = 0;
  //unsigned short sentences = 0, failed = 0;
  
  unsigned long start = millis();
  do 
  {
    while (ss.available())
      gps.encode(ss.read());
  } while (millis() - start < 1000); //read within 1 second

  //Serialprint(gps.satellites());
  gps.f_get_position(&flat, &flon, &age);
/*
  Serialprint(flat);
  Serialprint(" ");
  Serialprint(flon);
  Serialprint(" ");
  Serialprint(age);
  Serialprint(" ");
  Serialprint(gps.f_altitude());
  Serialprint(" ");
  Serialprint(gps.f_course());
  Serialprint(" ");
  Serialprint(gps.f_speed_kmph());
  Serialprint("\r\n");
*/
      
}

void(* resetFunc) (void) = 0;
void softResetDevice()
{
  asm volatile ("  jmp 0");
  //resetFunc();

}
