barisdinc/ASELSAN_4822/(commit log)

2016-10-16 Arduino Main File
    This is the arduino main file... I will split this file into libraries and header files in feature..
    But for dirty and fast coding I prefered to keep it all together...
2016-10-22 ArduinoNano pinouts declared
2016-10-22 SPI Duzenlemeleri yapildi..
2016-10-28 keypress timer added
2016-11-08 missing display last char corrected
    [ASELSAN_4822.ino]
2016-12-11 EEPROM Structure definitions added
    [EEpromContents.ods]
2016-12-11 EEPROM details modified
    [EEpromContents.ods]
2017-01-01 TA2GY PCB cizimi icin guncellemeler
    [Arduino-nano_4822-pinout_TA2GY_01012017.ods]
2017-01-04 PCB icin pin degisiklikleri
2017-01-04 PCB icin TA2GY acklamalari
    [Arduino-nano_4822-pinout_TA2GY.ods, Arduino-nano_4822-pinout_TA2GY_01012017.ods]
2017-01-08 Power ccontrol and sdisplay added
2017-01-21 VNA power presets
2017-01-21 VNA power presets 2
2018-02-26 Keypad Sorunu Giderildi. EEPROM Yazılım Versiyonu Arttırıldı. (v1.0b) PınChangeInt Kütüphanesi Eklendi. (Keypad Interrupt Durumlarını Daha Efektif Takip Etmek İçin)
2018-02-28 3.Parti PinChangeInterrupt kütüphanesi silindi. 18242B olan alan kullanımı 16.608B olarak küçültüldü. Interrupt vektörü direkt olarak implement edildi.
2018-02-28 Interrupt kütüphanesi silindi. 18242B olan alan tüketimi 16608B olarak küçültüldü. Interrupt vektörü implement edildi. (Keypad için)
2018-03-05 UHF Band Selection Added , EEPROM Radio Type Added , Frequency Validation For UHF Added , UHF Band Selection Table Added as Comment , EEPROM Structre Updated.
    [EEpromContents.ods]
2018-03-13 SHIFT problemi
    EEPROM da baslangic olarak 52 ve 53 adreslerinde 0 degeri olmasi baslangic SHIFT inin SIFR olmasina sebep oluyordu.
    if (frqSHIFT = 0) frqSHIFT=600;
    satiri ile bu hata duzeltildi.
    [ASELSAN_4822.ino]
2018-10-26 Message corrected back to TAMSAT
    [ASELSAN_4822.ino]
2018-10-26 bytes cannot have negative values... SHIFT problem fixed
    [ASELSAN_4822.ino]
2019-07-31 up down frq change fixed... power control fixed
    [ASELSAN_4822.ino]
2020-02-08 GPS + APRS + Beacon
    - APRS bitbanging added
    - GPS support added (TODO: tinyGPS, replace with a smaller GPS library)
    - some bug fixes
    [ASELSAN_4822.ino]
2020-02-10 bugunluk bu kadar yeter
    [ASELSAN_4822.ino]
2020-02-22 one touch REVERSE added
    [ASELSAN_4822.cpp]
2020-02-22 APRS timeout degeri seriden T 00 disinda bir deger yapilmis ise yani aktif ise ekranda A harfi gorunur
    [EEpromContents.ods]
2020-02-23 VNA transmission bug fixed
    [ASELSAN_4822.cpp]
2020-02-23 ISS via path fixed
    [ASELSAN_4822.cpp]
2020-02-23 bugfix : APRS counter variable size
    [ASELSAN_4822.cpp]
2020-02-23 bugfix APRS Ti meout
    [ASELSAN_4822.cpp]
2020-02-24 eeprom structure update
    [EEpromContents.ods]
2020-02-24 port/pin updates
    [Arduino-nano_4822-pinout_TA2GY.ods]
2020-03-02 fix shift
    [EEpromContents.ods]
2020-03-06 reversting for a clean startup
    [ASELSAN_4822.cpp]
2020-03-07 restructured current channel info
2020-03-07 tone_ctrl replaced with current_ch.tone_enabled
    [ASELSAN_4822.cpp]
2020-03-07 tone_pos replaced with current_ch.tone_enabled
    [ASELSAN_4822.cpp]
2020-03-07 shift dir replaced with current_ch.shift_dir
    [ASELSAN_4822.cpp]
2020-03-07 shift replaced with current_ch.shift
    [ASELSAN_4822.cpp]
2020-03-07 re-organising memory channels
    [EEpromContents.ods]
2020-03-08 new functions and bug fixes going on
    [EEpromContents.ods]
2020-03-29 watchdog timer and reset added
    [ASELSAN_4822.cpp]
2020-04-16 initialization commands bug fixed (e.g. : 666 does not erase freq limits)
    [ASELSAN_4822.cpp]
2020-04-16 VNA limits can be configured using 402 and 402 commands
    [EEpromContents.ods]
2020-05-27 Issue #44
    Arka plan ışığının tuşlara basılınca açılıp kapanması, Fix.
    [ASELSAN_4822.cpp]
2020-05-27 Issue #44
    better than before.
    [ASELSAN_4822.cpp]
2020-06-09 EEPROM location for TimeoutTimer
    [EEpromContents.ods]
2020-12-14 band selectro bug... tnx to onur arkut
    [ASELSAN_4822.cpp]
2025-09-26 Arduino projesi kendi dizinine tasiniyor
    [Arduino-nano_4822-pinout_TA2GY.ods, EEpromContents.ods]
2025-12-28 initial Pico version
2025-12-28 fixing leds
2025-12-29 ADC converterted to DMA
2026-06-21 ESP32 Core 3.x API uyumluluğu, DAC ISR optimizasyonları ve CTCSS ton güncellemeleri
2026-11-07 Fix PLL locking, TX and RX behaviour
    PLL kilitlemesi
    - PLL_SEC artik hic HIGH surulmuyor. Hat K3 kartindaki TD9 (74HC32,
    5V CMOS) OR kapisina gidiyor; 3.3V HIGH kapıyı esik bolgesinde birakip
    ENABLE sonrasi sahte CLOCK kenari uretiyordu. Bu fazladan kenar
    A-counter'a 0 biti kaydirip PD frekansinda (12.5 kHz) esit genlikli
    bir tasiyici taragi olusturuyordu.
    - R/N/A hesabi tek yola indirildi; RX/TX/UHF farki yalnizca LO ofsetinde.
    - PLL yazim profili setup() icinde uygulaniyor (varsayilan 100us bit).
    Onceden global 1000us degerinde kaliyor ve her yazim loop()'u ~100ms
    bloke ederek tus takimini kilitliyordu.
    - PLL hatlarina 12mA surme gucu, dahili pull'lar kapali.
    - PLL_SEC ve A/N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
2026-11-07 Harden EEPROM handling, fix keypad reset, gate WiFi at boot
    EEPROM saglamligi
    - Layout versiyonu (EEPROM_LAYOUT_VER_ADDR = 0xA6) eklendi. Surum
    uyusmazliginda EEPROM onarilip yeniden yaziliyor; eski/cop kayitlar
    artik yanlis davranisa yol acmiyor.
    - Acilista freqLimits, TOT ve mevcut kanal degerleri dogrulaniyor;
    aralik disi veya 25 kHz izgarasina oturmayan degerler varsayilana
    donuluyor ve tek seferde commit ediliyor.
    - initialize_eeprom() varsayilan kanali 145.575 yapiyor, tot_values'i
    sifir yerine 60sn/5sn olarak yaziyor, current_ch'yi de guncelliyor.
    - StoreFrequency ve StoreSpecialFrequency artik EEPROM.commit() cagiriyor;
    onceki kod yazip commit etmedigi icin ayarlar yenide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
2026-11-08 Update PCB v1.1, schematic and renders; enable WiFi at boot
    Donanim dosyalari
    - PCB v1.1 uretim dosyalari eklendi: Gerber, BOM ve PickAndPlace
    (2026-11-08). Eski v1.0 dosyalari pcb/ kokunden kaldirildi.
    - Sema (SCH_Schematic.pdf / .png) ve kart gorselleri (img1-4)
    yenilendi.
    Yazilim
    - WIFI_AT_BOOT 1: WiFi artik acilista baslatiliyor. v1.1 kartta besleme
    yolu duzeltildigi icin CYW43 tepe akimi artik brownout yaratmiyor.
    - softAP oncesi softAPConfig(192.168.4.1/24) eklendi; AP adresi sabit.
    - write_FRQ icinde LCD guncellemesi validFRQ kontrolunden once tasindi;
    gecersiz frekansta da ekran tutarli kaliyor.
    - Acilista ve her tus olayindan sonra PLL yeniden kilitleniyor
    (SetPLLLock), b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
2026-11-10 Fix stack buffer overflows, EEPROM memory channel collisions, and UHF initialization
    - SerialMenu.cpp & ASELSAN_4822.cpp: Fix off-by-one stack buffer overflow in commandDumpConfig() where CallSign[6] and Message[8] were written on 6-byte and 8-byte arrays. Expanded to CallSign[7] and Message[9] to accommodate null terminators.
    - EEPROM_Manager.cpp & ASELSAN_4822.cpp: Enforce 1..50 memory channel boundaries in StoreFrequency() and GetMemoryChannel(). Channels > 50 previously overflowed into WebUI settings, RF power, Squelch levels, and WiFi password at offset 750+.
    - SerialMenu.cpp & ASELSAN_4822.cpp: Fix commandMemoryDump() loop bounds from 0..99 to 1..50.
    - EEPROM_Manager.cpp & main.cpp: Pr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
